juanlu-a/viro_vision/hardware/case-via-clara/README.md

# Carcasa VIA Clara v0.29: dos mitades con cierre a presión

Modelo paramétrico en **OpenSCAD** (`via_clara_v0_29.scad`) para la Raspberry Pi Zero 2 W con el header
soldado, la Waveshare UPS HAT (C) unida a su batería 803040, la Raspberry Pi AI Camera y el auricular
de conducción ósea, montado sobre la patilla de los lentes.

Estado al 2026-11-12, con el PR que integró cada hito a `staging`:

- **v0.20** (#124): impresa y armada completa el 2026-10-30, quedó perfecta. Puesta, la foto salía
  girada 90°, y de ahí salió la línea v0.22 a v0.29 (ver abajo).
- **v0.26** (#129, 2026-11-10): la cámara girada, de modo que la foto sale derecha con el equipo puesto.
- **v0.29, la final** (#131, 2026-11-12): impresa y armada, con la copa del auricular como pieza aparte
  (08) y un enchufe de 6,0 mm que calza perfecto. La v0.27 se imprimió y sólo falló el encastre de la
  copa, que quedaba flojo; la v0.28 achicó el enchufe por error; la v0.24 también se imprimió y se armó.
  El equipo confirmó que no queda nada por probar.
- La v0.8 (`via_clara_v0_8.scad`) se conserva como referencia.

Se imprime en una **FLSUN T1 Max** (las primeras versiones, en una Creality Ender 3 V3): la FLSUN dio bordes
más definidos, mejor terminación y soportes que se retiran con menos marcas.
Para regenerar todo, correr `./export.sh`: arma los STL, las imágenes y las verificaciones, y sale con
error si algo falla.

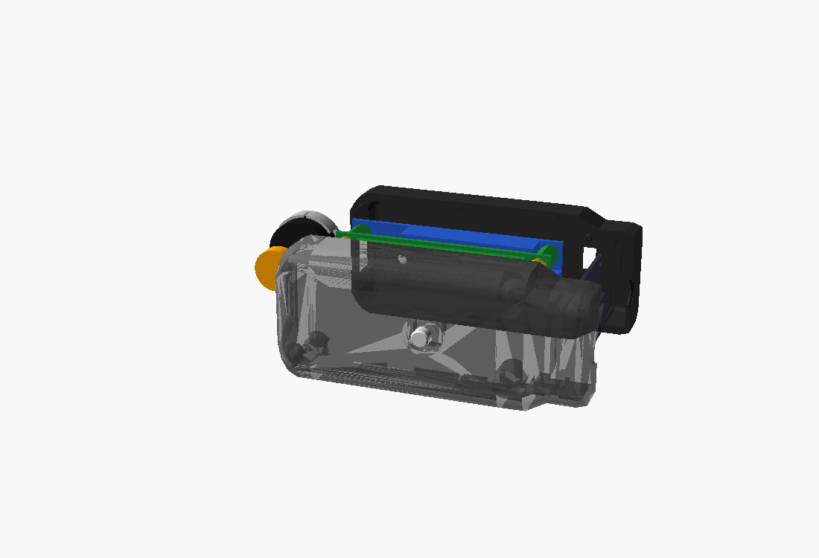
[picture p1: hardware/case-via-clara/img/exploded_with_hardware.png]
Explotada, con las placas y la cámara


Las mitades miden **89,2 mm de largo y 39,8 de alto**, sin contar el brazo del auricular.

## De la v0.20 a la v0.29

Con la v0.20 puesta, la foto salía girada 90°. El detector del ómnibus (YOLO) corre dentro del sensor IMX500,
así que la imagen no se puede girar por software antes de que el detector la vea. Se probaron dos caminos:

- **v0.21**: la carcasa entera girada, con la cara de la HAT arriba. Se descartó.
- **v0.22**: la v0.20 con **sólo la cámara girada**, un cuarto de vuelta en su plano, junto con sus guías.
  El conector del flex mira hacia abajo, hacia la junta, y el lado de 25 mm de la placa queda a lo ancho. El
  flex sale hacia abajo, va hacia atrás por el piso y sube frente a la Pi (`flex_keepout` reserva ese camino).
  El lente queda en la junta, así que el agujero es el lente más 0,4 (8,4). **Es la línea elegida.**

Lo que se fue corrigiendo sobre la v0.22:

| Versión | Cambio | Por qué |
|---|---|---|
| v0.23 | cámara 2 mm más lejos de las placas (10 mm de hueco); la carcasa crece 2 mm | ahí va enrollado el flex |
| v0.23 | tapa del auricular 1,5 mm más alta (`GRILLE_RAISE`), con dedos más largos | la de la v0.22 no hacía click en el brazo |
| v0.24 | ranura de la microSD 1 mm hacia la junta | medida en la impresión |
| v0.24 | guía delantera de la cámara abierta en toda la franja de abajo (7 mm), en las dos mitades | el componente de la cámara rozaba |
| v0.25 | botón centrado en la cara externa | no estaba centrado |
| v0.25 | hueco interior 1,2 mm más alto de cada lado: la carcasa pasa de 37,2 a 39,8 de alto | el mini HDMI y el micro USB de la Pi sobresalen 2 mm del borde, no 0,8; el conjunto entraba a la fuerza. Guías en la pared no entraban: caían sobre las trabas de abajo |
| v0.25 | zócalos hexagonales 2 mm más profundos (5,5) | los hexágonos hacían tope antes de tiempo |
| v0.25 | ganchos de las trabas más anchos (7 y 5 mm) y diente de 0,5 | más robustas |
| v0.25, v0.26 | puentes del elástico 5,5 mm arriba del centro (`ELASTIC_Z`) y zócalo del brazo 5,5 abajo (`ARM_Z`): 11 mm entre la patilla y el brazo; el auricular sigue a la patilla | la patilla del lente pasaba justo por encima del brazo y no se podía usar puesto |
| v0.27 | la copa del auricular, pieza aparte (08), encastrada en la punta del brazo como el brazo en la carcasa | pasar el cable por el brazo era difícil |
| v0.27 | canal del cable de Ø 3,4 (pared del tubo de 1 mm), curva de 3 mm de radio dentro del enchufe y paso de Ø 3,8 abierto en embudo hacia adentro | el cable no pasaba bien: era chico y doblaba a 90° |
| v0.28 | enchufe del brazo para la copa de 5,1 × 5,1, con la copa igual | se supuso que el brazo de la v0.27 no entraba; era al revés |
| v0.29 | enchufe de 6,0 × 6,0 con esquinas de 0,8 (0,15 de luz por lado) y puntas de prueba de 5,8, 6,0 y 6,2 (`test_cup_plug_*`, `PART=print_cup_plug_test` con `CUP_PLUG_TEST`) | el brazo de la v0.27 quedaba flojo en la copa, y el de la v0.28 más todavía |

## Piezas

| STL | Qué es | Orientación | Soportes |
|---|---|---|---|
| `01_left_half` | mitad del lado de la cabeza, con el switch de encendido | cara cabeza abajo | bajo la cara cabeza; bloquearlos dentro de la cavidad |
| `02_right_half` | mitad externa: zócalos, botón, trabas | cara externa abajo | sólo bajo el ahusado trasero y la nariz; **ninguno dentro de los zócalos hexagonales**. Después de imprimir, cortar los puentes de las vigas de las trabas |
| `03_bone_arm` | brazo del auricular, con un enchufe en cada punta | acostado | de árbol |
| `08_transducer_cup` | copa del auricular, con el zócalo para el brazo | piso abajo | no |
| `04_mode_button` | botón: un cilindro que se pega al pulsador | parado | no |
| `07_transducer_cover` | tapa a click del auricular, con una ranura hacia el oído | disco abajo | no |
| `00_assembly_check` | todo armado | no aplica | **no se imprime**: para mirar en el laminador |

Ya no existen la corredera (05), que reemplaza el switch de panel, ni la tapita del botón (06): el
pulsador queda firme en su bolsillo. PLA con *fuzzy skin* en el exterior; boquilla 0,4, capa de 0,12 a 0,16, 3 perímetros. Las curvas salen con 128 segmentos.

**Lo que dejó la impresión de la v0.24** (FLSUN T1 Max, PLA, con fuzzy skin):

- la **02 boca arriba** (cara externa en la cama), siempre: las vigas de las trabas están pensadas para
  imprimirse así, y boca abajo los ganchos quedarían colgando de la junta;
- la **01 boca abajo** (junta en la cama) deja el exterior muy prolijo, pero el borde de la junta pierde
  definición y las trabas no enganchan bien. Para probar: apagar el fuzzy skin en los primeros 3 mm (un
  modificador por altura) y compensar la pata de elefante con 0,2 mm. Si no alcanza, la alternativa es
  imprimirla boca arriba, como dice la tabla.

## Lo que fijaron las impresiones (v0.12 a v0.25)

| Parte | Cómo quedó | De dónde salió |
|---|---|---|
| Cámara | ranura del PCB de 1,62 (nervios de 1,2 a 0,25 de luz), 5 mm del centro del nervio delantero a la cara, 4,2 mm de lugar para el flex, y la esquina del nervio delantero abierta, porque ahí la cámara tiene un componente | narices de prueba de la v0.12 y la v0.13 |
| Trabas delanteras | detrás de las guías de la cámara: encima de ellas costaban y se partieron | impresión de la v0.11 |
| Separadores sobre la Pi | **zócalos hexagonales huecos de 5,0 entre caras, 5,5 de profundidad**, en postes de Ø 8,2 recortados donde tocarían el header y los puertos | `test_hex_sizes` (v0.13; el 5.º tamaño), la v0.15, que con 1,5 no cerraba, y la v0.24, donde 3,5 hacía tope |
| Auricular | redondo, Ø 14 × 5: copa de **Ø 17 × 6** (la de Ø 15 no entró) y tapa sólida a click con una ranura hacia el oído | v0.15 a v0.17 |
| Botón | un cilindro de Ø 5, pegado al pulsador SMD de 4 × 4 × 1 | v0.15 |
| Encendido | **switch deslizante de panel**, cableado al HAT, en lugar de la llave del HAT y la corredera impresa. Ventana de **4,2 × 7,4** en la cara cabeza y dos pernos de **Ø 2,3 a 14,8** entre centros y 2 de alto, para los agujeros de la pestaña; se fija con gotita. La ventana va 2 mm más abajo que la de la corredera, para que la pestaña no toque la esquina redondeada de arriba | `test_panel_switch` (v0.18 y v0.19) |

## Todas las versiones

`versions/` guarda los STL de cada versión tal como se mandaron a imprimir, con su `LEEME`: de la v0.9 a
la v0.29 (desde la v0.21, también el `.scad` de cada una en `modelo/`), incluidas las piezas de prueba (narices, tamaños de hexágono, separaciones del switch). Es el
registro del proceso: no se borra ni se pisa una versión anterior. `./export.sh` vuelve a crear los STL
de la versión vigente en `stl/`, que git ignora.

## Armado

1. **Botón.** Soldar los cables al pulsador de 4 × 4 y pegarle el cilindro (pieza 04). Meterlo desde
   adentro de la mitad derecha, con el cilindro por el agujero.
2. **Cámara y flex.** Conectar el flex a la cámara y al CSI de la Pi **antes** de poner el conjunto.
3. **Electrónica.** Bajar el conjunto HAT + batería + Pi, **con la Pi hacia abajo**, en la mitad derecha:
   los hexágonos de la Pi entran en los zócalos. La cámara entra en su ranura con el conector hacia abajo (hacia la junta) y el lado de 25 mm a lo ancho; el flex baja, va por el piso y sube frente a la Pi hasta su conector.
4. **Switch.** En la mitad izquierda, desde adentro, pasar la perilla del switch por su ventana y
   calzar la pestaña en los dos pernos; una gota de gotita.
5. **Auricular.** Pasar el cable por el puerto de la mitad izquierda, por el brazo (pieza 03) y por la
   copa (pieza 08); encastrar la copa en la punta del brazo y el brazo en su zócalo, poner el
   transductor en la copa y cerrar con la tapa (pieza 07).
6. **Cerrar.** Bajar la mitad izquierda sobre la derecha hasta escuchar las ocho trabas. Para abrir:
   uña o moneda en la ranura trasera.

## Guía con flechas

`img/guide/` tiene cinco vistas con flechas que dicen para qué es cada ranura, agujero y pieza
(`outer`, `head`, `left_inside`, `right_inside`, `exploded`). Las genera `export.sh` a partir de
`via_clara_v0_29_guide.scad`.

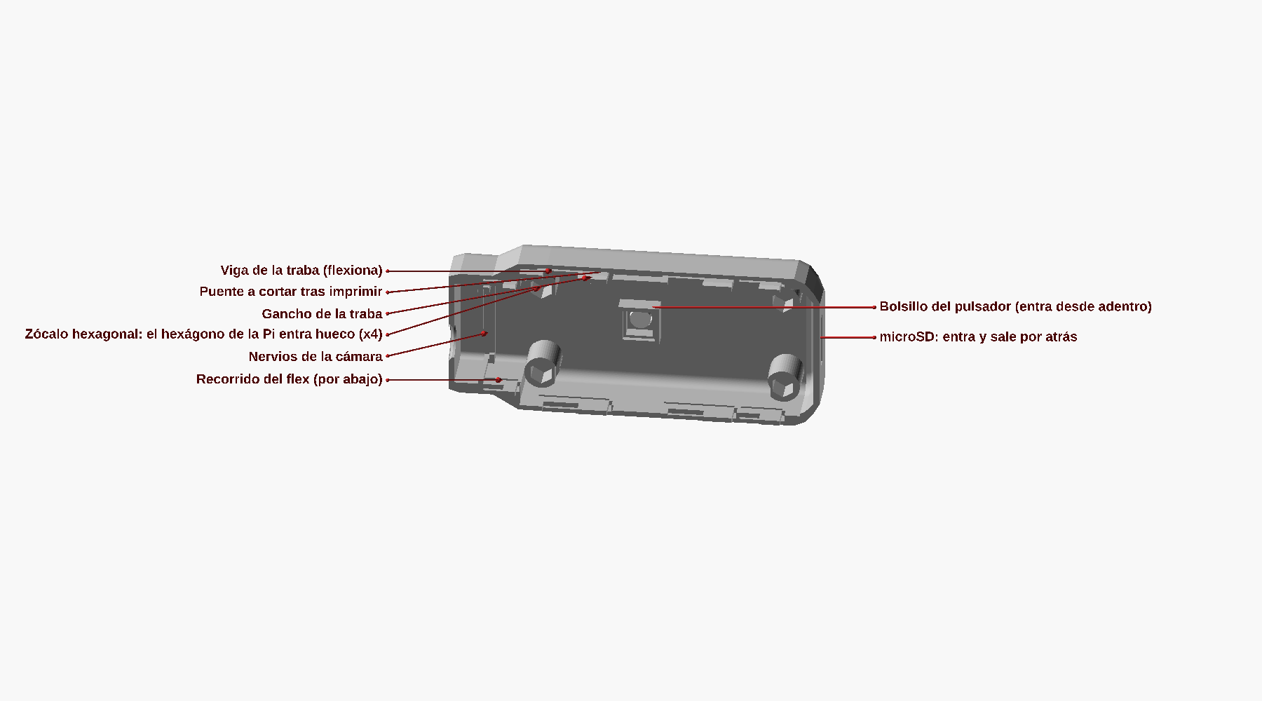
[picture p2: hardware/case-via-clara/img/guide/right_inside.png]
Adentro de la mitad derecha

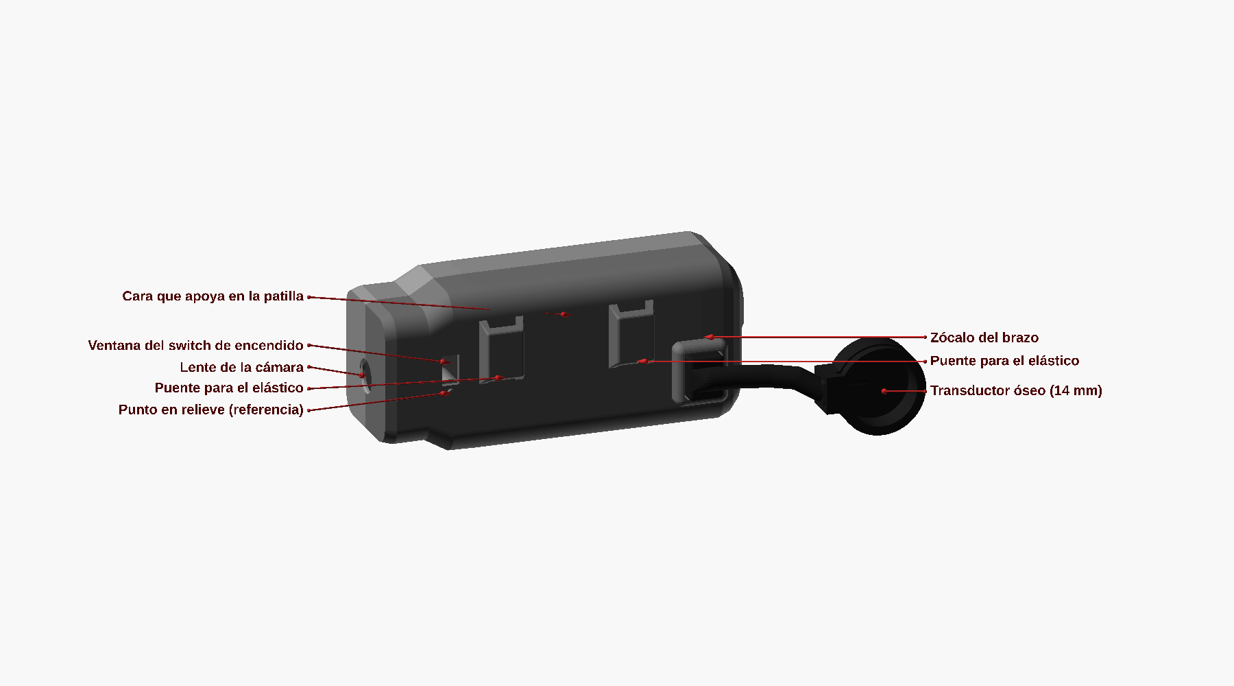
[picture p3: hardware/case-via-clara/img/guide/head.png]
Cara cabeza


## Archivos y verificaciones

```
via_clara_v0_29.scad         el modelo. PART = assembly | left | right | bone | cup | button | grille |
                             print_* | hardware | check_*;  SHOW_HW y EXPLODE para la vista armada
via_clara_v0_29_guide.scad   la guía con flechas (img/guide/); no se imprime
via_clara_v0_8.scad          la versión de partida, sin tocar, como referencia
export.sh                    regenera stl/ e img/ y corre las verificaciones
versions/                    los STL de cada versión, v0.9 a v0.29
```

`export.sh` comprueba que cada pieza imprimible sea **un solo sólido** que apoya en la cama, y corre
**18 verificaciones** de interferencia que tienen que dar vacío o un contacto de volumen cero: las
mitades entre sí y contra las maquetas del hardware, los zócalos contra los hexágonos, el botón, los
pernos del switch, el recorrido del flex, el brazo y su tapa, y los caminos de armado (botón, conjunto,
cámara). Valen **contra las maquetas**, y las maquetas valen tanto como las medidas: lo que no tienen
(el cuerpo del switch de panel, por ejemplo) no lo ven.

## De dónde salen las medidas

| Componente | Fuente |
|---|---|
| Raspberry Pi Zero 2 W | plano mecánico oficial: 65 × 30, agujeros 58 × 23 |
| AI Camera | product brief (sept. 2024), pág. 4, corregido con las impresiones |
| UPS HAT (C) | wiki de Waveshare (fotos escaladas) y la impresión de la v0.9 |
| Hexágonos, disipador, pulsador, auricular, switch | medidos con calibre y con piezas de prueba |

El conjunto, de la cara cabeza a la externa: cabezas de los tornillos Phillips, UPS HAT, batería
(del lado de los pogo pins), Pi, y encima de la Pi el header y los hexágonos. Adelante quedan el CSI
y la cámara; atrás, la microSD (sale por una ranura del extremo trasero) y el micro USB de carga.
