juanlu-a/viro_vision/hardware/raspi/requirements-mac.txt

# Only for the device emulator on macOS (python -m virovision.emulator). It does not go to the device.
bless==0.3.0
