juanlu-a/viro_vision/docs/mediciones/README.md

# Mediciones

Registro de las campañas de medición del proyecto: **los datos crudos y el método**, un archivo por
campaña, con fecha en el nombre.

Existe separado de [`../pruebas-y-decisiones.md`](../pruebas-y-decisiones.md) por la misma razón por
la que el diagrama canónico vive en un solo lugar: ahí va **el análisis y la decisión** —que es lo
que entra al documento final de la tesis— y acá los números completos que la respaldan, para que la
conclusión se pueda auditar y la medición se pueda repetir sin reconstruirla de memoria.

Regla: una campaña no se edita después de corrida. Si se vuelve a medir, es un archivo nuevo. Los
números viejos son el registro de qué se sabía cuándo, y borrarlos hace que las decisiones tomadas
con ellos parezcan arbitrarias.

| Campaña | Qué midió |
|---|---|
| [2026-09-02 — modelos de supermercado](2026-09-02-modelos-supermercado.md) | Latencia, acierto, cuota, costo y efecto del tamaño de imagen de los tres proveedores con clave. |
| [2026-09-15 — el modo ómnibus en la placa](2026-09-15-omnibus-en-placa.md) | Latencia del camino de ómnibus entero corriendo en el dispositivo, disparado por el botón. |
