juanlu-a/viro_vision/hardware/case-via-clara/img/closed_head_side.png

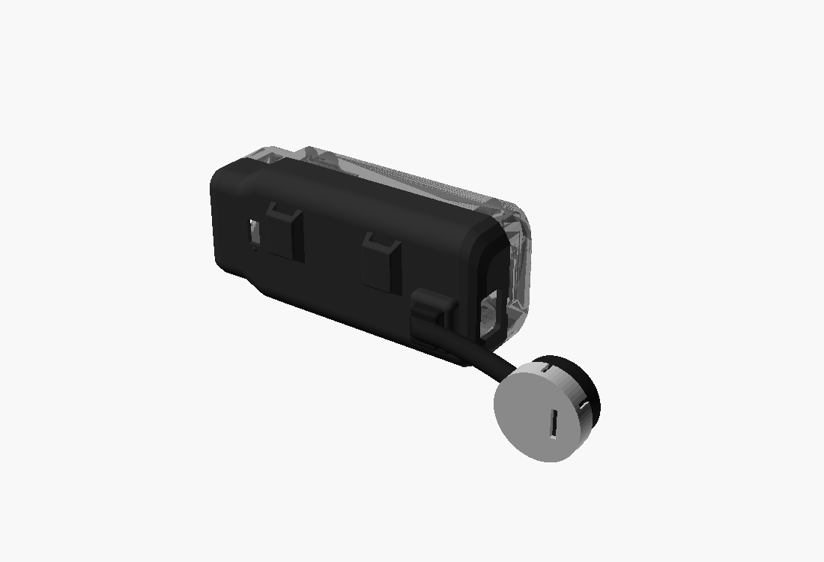
hardware/case-via-clara/img/closed_head_side.png
