juanlu-a/viro_vision/hardware/case-via-clara/img/closed_outer.png

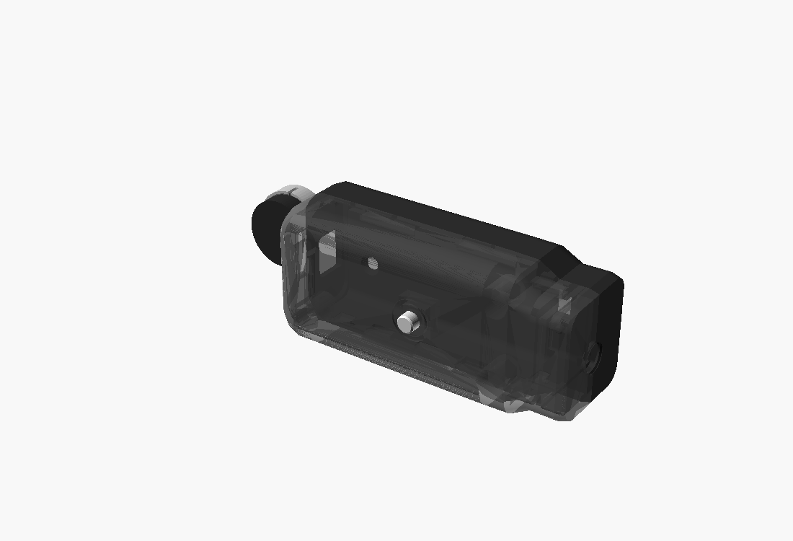
hardware/case-via-clara/img/closed_outer.png
