juanlu-a/viro_vision/hardware/case-via-clara/img/head_side_switch.png

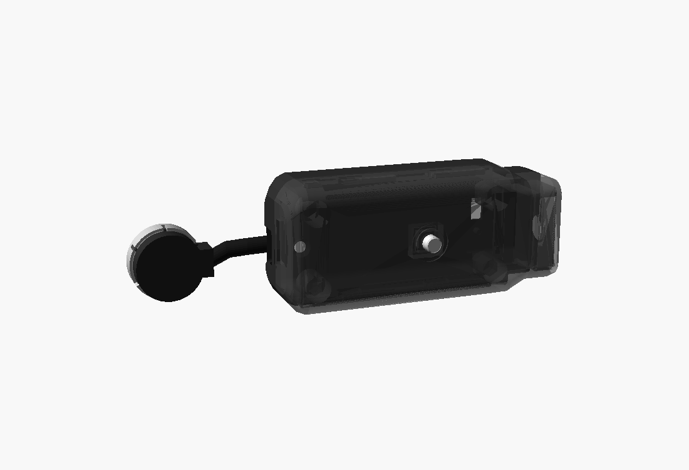
hardware/case-via-clara/img/head_side_switch.png
