juanlu-a/viro_vision/hardware/case-via-clara/img/left_half_inside.png

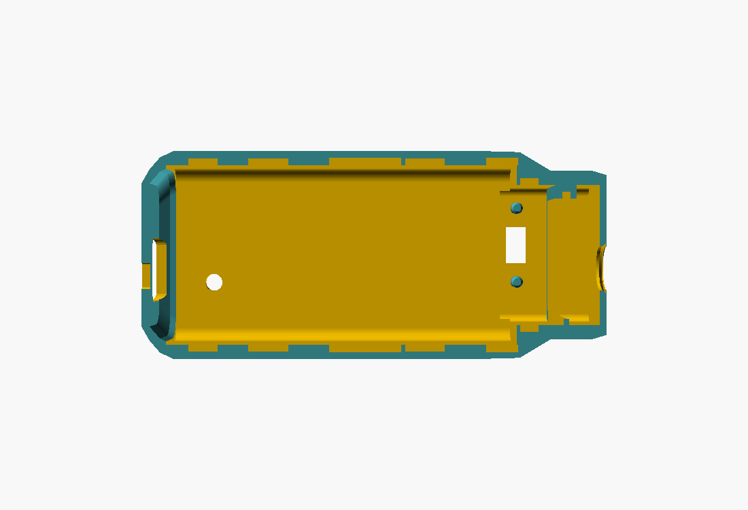
hardware/case-via-clara/img/left_half_inside.png
