juanlu-a/viro_vision/hardware/case-via-clara/img/rear_openings.png

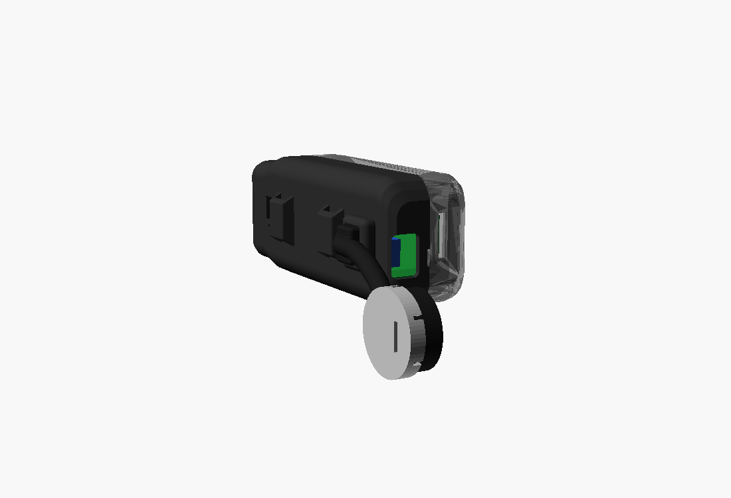
hardware/case-via-clara/img/rear_openings.png
