juanlu-a/viro_vision/hardware/case-via-clara/versions/v0_29/pruebas/test_cup_plug_6_2_v0_29.stl

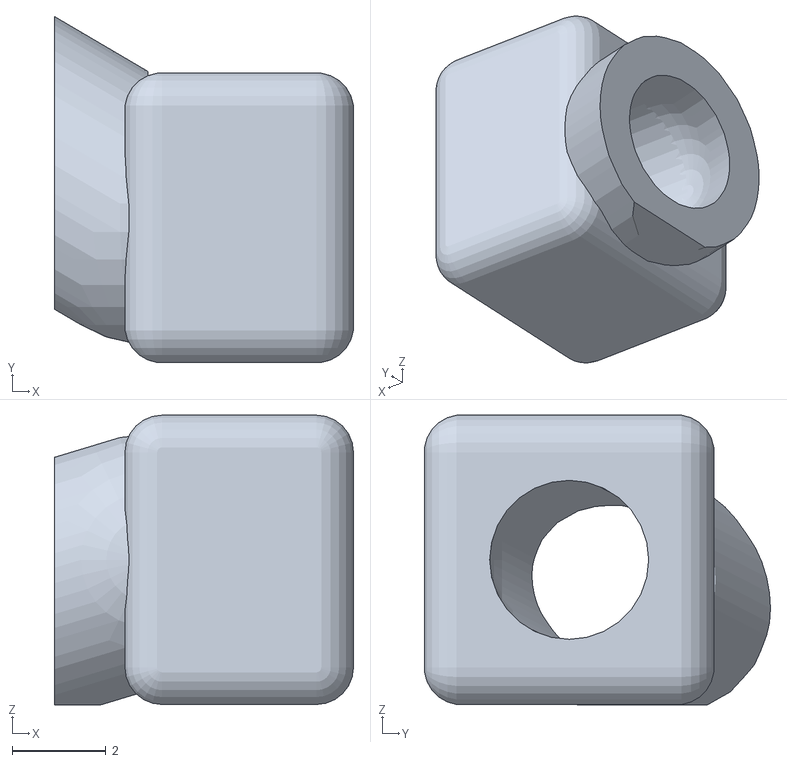
[picture p10: CAD file, 2026-11-12]
hardware/case-via-clara/versions/v0_29/pruebas/test_cup_plug_6_2_v0_29.stl
6.39 x 7.40 x 6.19
