juanlu-a/viro_vision/hardware/case-via-clara/versions/v0_29/pruebas/test_cup_plug_6_0_v0_29.stl

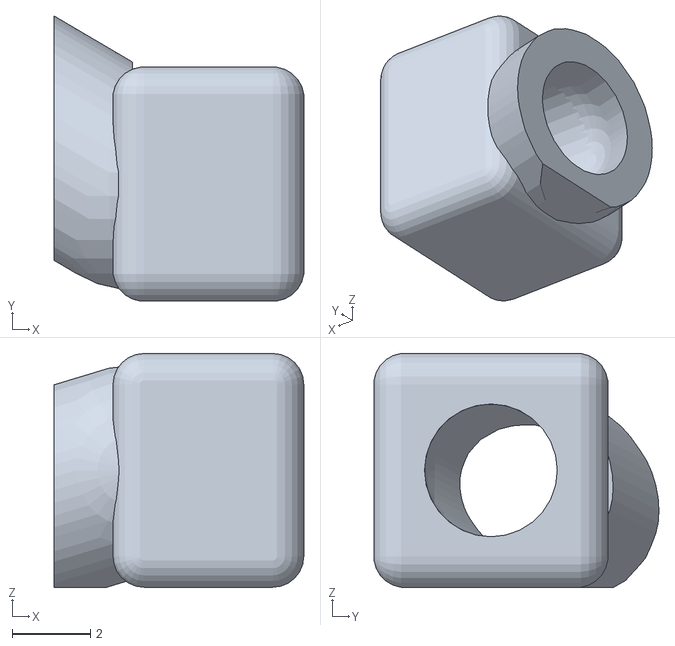
[picture p11: CAD file, 2026-11-12]
hardware/case-via-clara/versions/v0_29/pruebas/test_cup_plug_6_0_v0_29.stl
6.39 x 7.30 x 5.99
