juanlu-a/viro_vision/hardware/case-via-clara/versions/v0_11/con_tapa/00_assembly_check_v0_11_tapa.stl

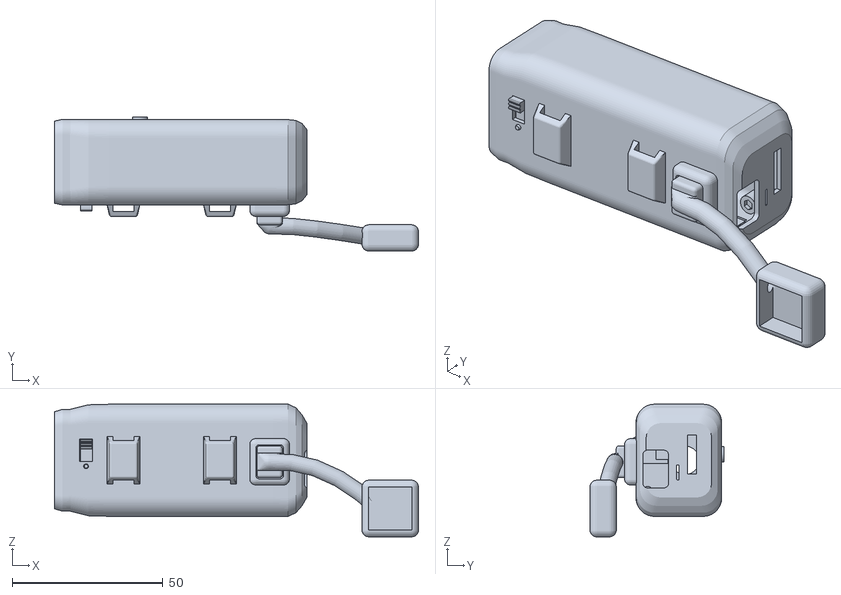
[picture p12: CAD file, 2026-10-31, an earlier design]
hardware/case-via-clara/versions/v0_11/con_tapa/00_assembly_check_v0_11_tapa.stl
120.8 x 44.5 x 44.0
