juanlu-a/viro_vision/hardware/case-via-clara/versions/v0_15/00_assembly_check_v0_15.stl

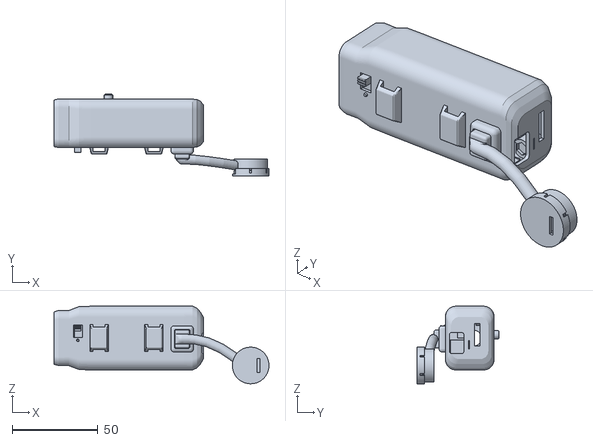
[picture p13: CAD file, 2026-10-31, an earlier design]
hardware/case-via-clara/versions/v0_15/00_assembly_check_v0_15.stl
125.5 x 47.8 x 45.3
