juanlu-a/viro_vision/hardware/case-via-clara/versions/v0_10/00_assembly_check_v0_10.stl

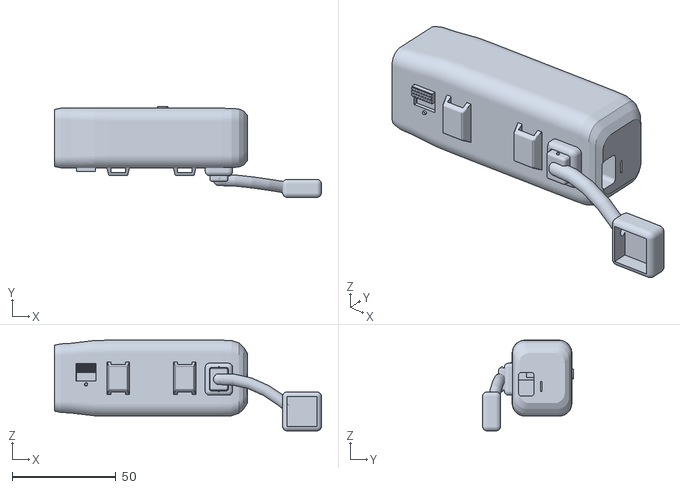
[picture p14: CAD file, 2026-10-31, an earlier design]
hardware/case-via-clara/versions/v0_10/00_assembly_check_v0_10.stl
128.5 x 43.8 x 43.7
