juanlu-a/viro_vision/hardware/case-via-clara/versions/v0_14/00_assembly_check_v0_14.stl

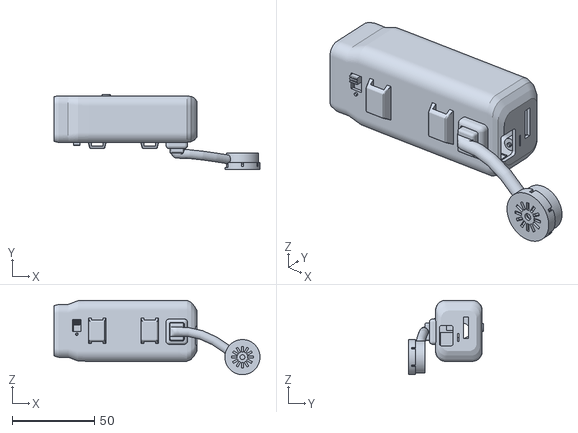
[picture p15: CAD file, 2026-10-31, an earlier design]
hardware/case-via-clara/versions/v0_14/00_assembly_check_v0_14.stl
125.5 x 45.7 x 45.3
