juanlu-a/viro_vision/hardware/case-via-clara/versions/v0_24/00_assembly_check_v0_24.stl

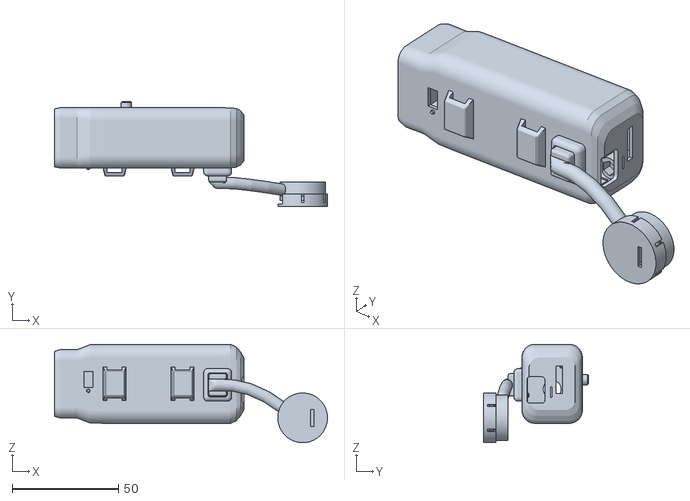
[picture p16: CAD file, 2026-11-10, an earlier design]
hardware/case-via-clara/versions/v0_24/00_assembly_check_v0_24.stl
128.5 x 49.2 x 46.3
