juanlu-a/viro_vision/hardware/case-via-clara/versions/v0_10/03_bone_arm_v0_10.stl

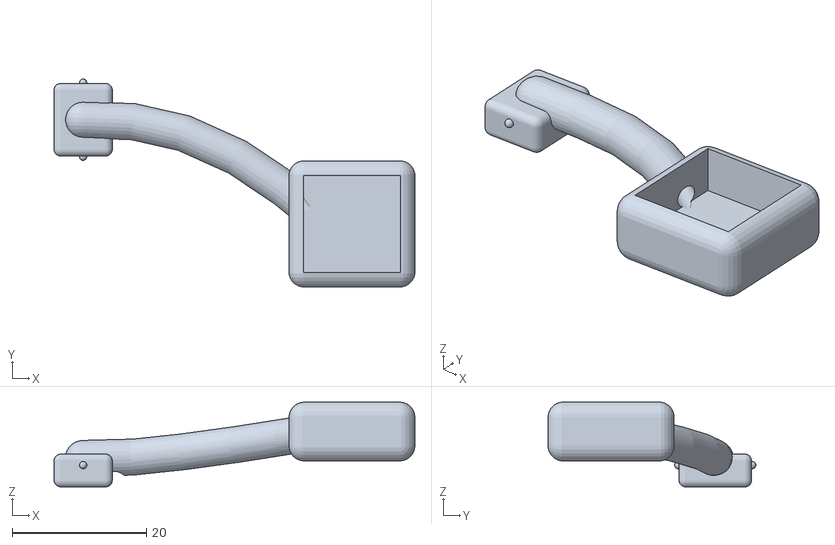
[picture p17: CAD file, 2026-10-31, an earlier design]
hardware/case-via-clara/versions/v0_10/03_bone_arm_v0_10.stl
53.7 x 30.9 x 12.6
