juanlu-a/viro_vision/hardware/case-via-clara/versions/v0_11/01_left_half_v0_11.stl

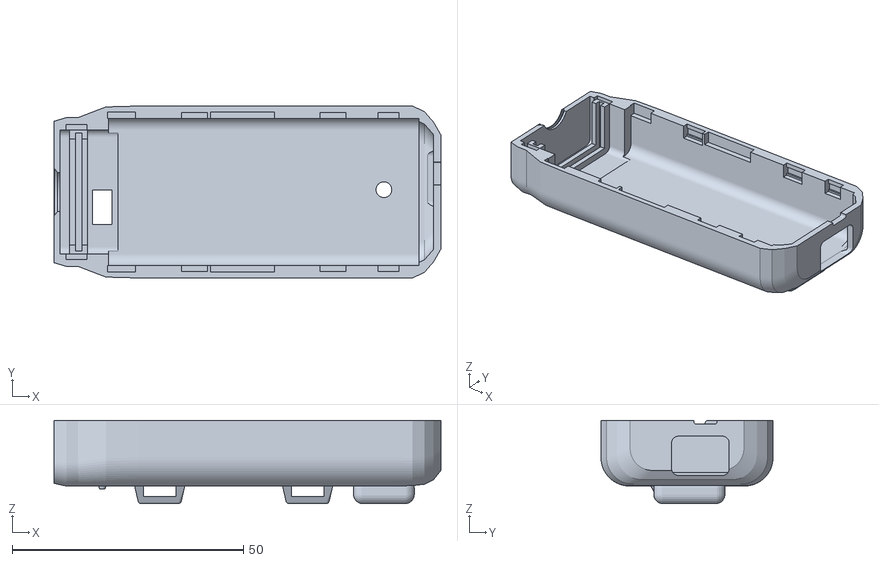
[picture p18: CAD file, 2026-10-31, an earlier design]
hardware/case-via-clara/versions/v0_11/01_left_half_v0_11.stl
83.7 x 37.2 x 18.0
