juanlu-a/viro_vision/hardware/case-via-clara/versions/v0_12/ranura_+0.2/test_nose_right_slot_plus02_v0_12.stl

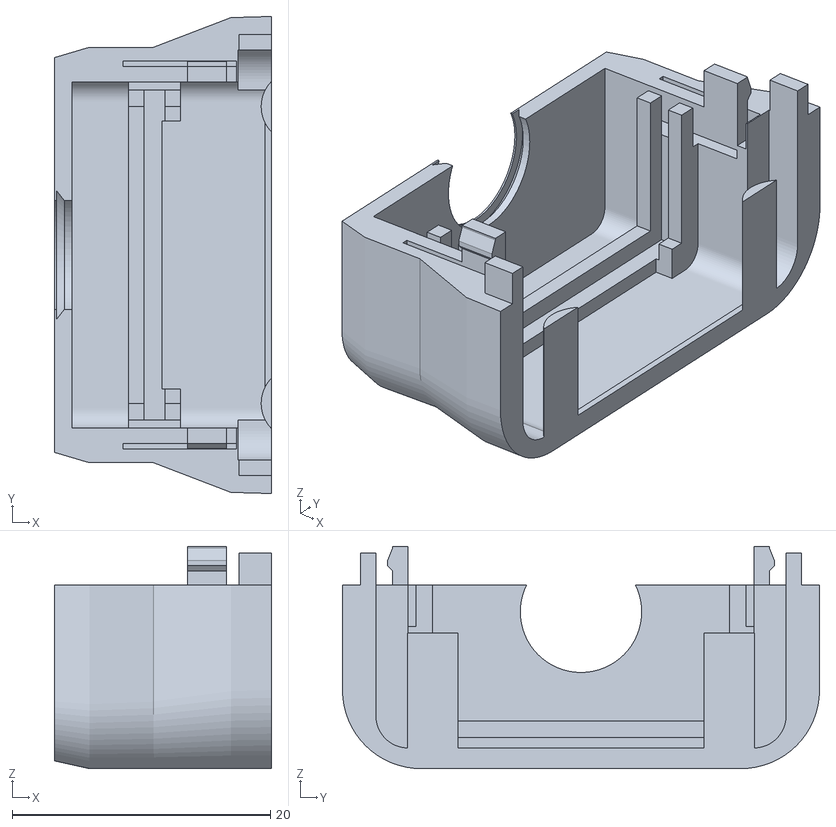
[picture p19: CAD file, 2026-10-31, an earlier design]
hardware/case-via-clara/versions/v0_12/ranura_+0.2/test_nose_right_slot_plus02_v0_12.stl
16.8 x 37.0 x 17.2
