juanlu-a/viro_vision/hardware/case-via-clara/versions/v0_12/test_pads_v0_12.stl

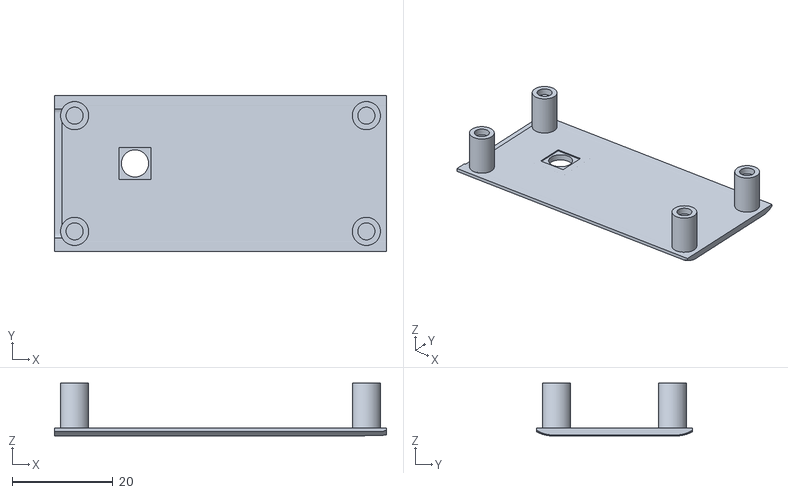
[picture p20: CAD file, 2026-10-31, an earlier design]
hardware/case-via-clara/versions/v0_12/test_pads_v0_12.stl
66.0 x 31.0 x 10.5
