juanlu-a/viro_vision/hardware/case-via-clara/versions/v0_13/test_hex_sizes_v0_13.stl

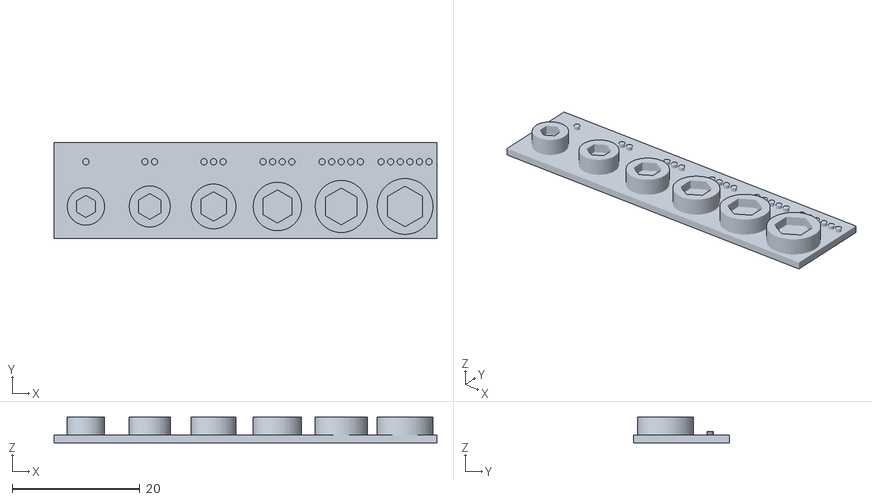
[picture p21: CAD file, 2026-10-31, an earlier design]
hardware/case-via-clara/versions/v0_13/test_hex_sizes_v0_13.stl
60.0 x 15.0 x 4.00
