juanlu-a/viro_vision/hardware/case-via-clara/versions/v0_14/02_right_half_v0_14.stl

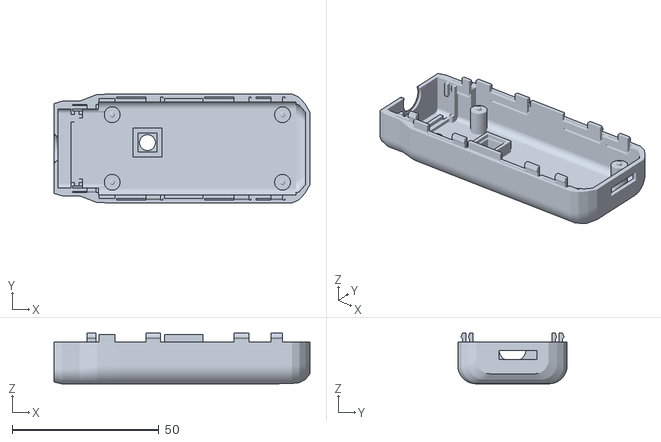
[picture p22: CAD file, 2026-10-31, an earlier design]
hardware/case-via-clara/versions/v0_14/02_right_half_v0_14.stl
87.2 x 37.2 x 17.2
