juanlu-a/viro_vision/hardware/case-via-clara/versions/v0_17/03_bone_arm_v0_17.stl

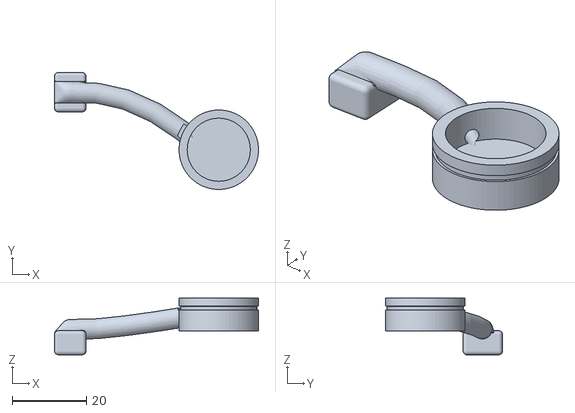
[picture p23: CAD file, 2026-10-31, an earlier design]
hardware/case-via-clara/versions/v0_17/03_bone_arm_v0_17.stl
54.9 x 31.5 x 15.2
