juanlu-a/viro_vision/hardware/case-via-clara/versions/v0_19/pernos_2.9/test_panel_switch_v0_19_d2.9.stl

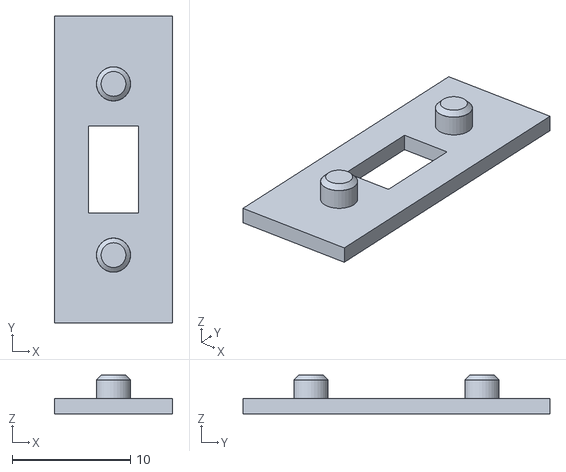
[picture p24: CAD file, 2026-10-31, an earlier design]
hardware/case-via-clara/versions/v0_19/pernos_2.9/test_panel_switch_v0_19_d2.9.stl
10.0 x 26.0 x 3.28
