juanlu-a/viro_vision/(list of files, cad)

Other CAD files:
hardware/case-via-clara/versions/v0_16/00_assembly_check_v0_16.stl
hardware/case-via-clara/versions/v0_18/03_bone_arm_v0_18.stl
hardware/case-via-clara/versions/v0_19/test_panel_switch_v0_19.stl
hardware/case-via-clara/via_clara_v0_8.scad
hardware/case-via-clara/versions/v0_9/via_clara_v0_9_guide.scad
hardware/case-via-clara/versions/v0_21/modelo/via_clara_v0_21.scad
hardware/case-via-clara/versions/v0_10/04_mode_button_v0_10.stl
hardware/case-via-clara/versions/v0_10/05_power_slider_v0_10.stl
hardware/case-via-clara/versions/v0_11/con_tapa/06_button_lid_v0_11.stl
hardware/case-via-clara/versions/v0_11/con_tapa/07_camera_cap_v0_11_tapa.stl
hardware/case-via-clara/versions/v0_13/test_nose_left_v0_13.stl
hardware/case-via-clara/versions/v0_15/07_transducer_cover_v0_15.stl
hardware/case-via-clara/versions/v0_16/02_right_half_v0_16.stl
hardware/case-via-clara/versions/v0_18/test_panel_switch_v0_18.stl
hardware/case-via-clara/versions/v0_20/02_right_half_v0_20.stl
hardware/case-via-clara/versions/v0_21/02_bottom_half_v0_21.stl
hardware/case-via-clara/versions/v0_21/modelo/via_clara_v0_21_guide.scad
hardware/case-via-clara/versions/v0_21/pruebas/test_nose_left_v0_21.stl
hardware/case-via-clara/versions/v0_21/pruebas/test_nose_right_v0_21.stl
hardware/case-via-clara/versions/v0_21/pruebas/test_pads_v0_21.stl
hardware/case-via-clara/versions/v0_22/modelo/via_clara_v0_22_guide.scad
hardware/case-via-clara/versions/v0_23/01_left_half_v0_23.stl
hardware/case-via-clara/versions/v0_23/02_right_half_v0_23.stl
hardware/case-via-clara/versions/v0_23/modelo/via_clara_v0_23.scad
hardware/case-via-clara/versions/v0_24/02_right_half_v0_24.stl
hardware/case-via-clara/versions/v0_24/03_bone_arm_v0_24.stl
hardware/case-via-clara/versions/v0_24/modelo/via_clara_v0_24_guide.scad
hardware/case-via-clara/versions/v0_24/pruebas/test_nose_right_v0_24.stl
hardware/case-via-clara/versions/v0_25/01_left_half_v0_25.stl
hardware/case-via-clara/versions/v0_25/modelo/via_clara_v0_25.scad
hardware/case-via-clara/versions/v0_26/pruebas/test_nose_right_v0_26.stl
hardware/case-via-clara/versions/v0_26/pruebas/test_pads_v0_26.stl
hardware/case-via-clara/versions/v0_27/03_bone_arm_v0_27.stl
hardware/case-via-clara/versions/v0_27/08_transducer_cup_v0_27.stl
hardware/case-via-clara/versions/v0_28/08_transducer_cup_v0_28.stl
hardware/case-via-clara/versions/v0_28/modelo/via_clara_v0_28.scad
hardware/case-via-clara/versions/v0_9/02_right_half_v0_9.stl
hardware/case-via-clara/versions/v0_9/04_mode_button_v0_9.stl
