juanlu-a/viro_vision/docs/brand/virovision-manual-de-marca.pdf

M A N U A L D E M A R C A · V 1 . 0 · 2 0 2 6

# ViroVision

Asistente de hardware para personas

ciegas. Una cámara con IA que reconoce

líneas de colectivo y productos de

supermercado, y lo comunica por voz.

Solo símbolo Técnico y sobrio

Verde + azul

## El símbolo

01

Dos arcos que se encuentran en un vértice inferior. Leídos

juntos forman un ojo abstracto; leídos por su punto de

unión, una V geométrica. El punto central es la pupila y

también el objeto detectado: el foco de la cámara.

El arco azul representa el dispositivo; el verde, la lectura

confirmada. La marca funciona sin texto: es un símbolo

único, sin logotipo acompañante.

## Construcción y resguardo

02

Lienzo 200×200 ·
radio de arco 96 ·
trazo 18 · pupila
r17 en (100, 92)

Área de resguardo =
1× el diámetro de la
pupila (34 u) en los
cuatro lados. Tamaño
mínimo: 24 px en
pantalla, 10 mm
impreso.

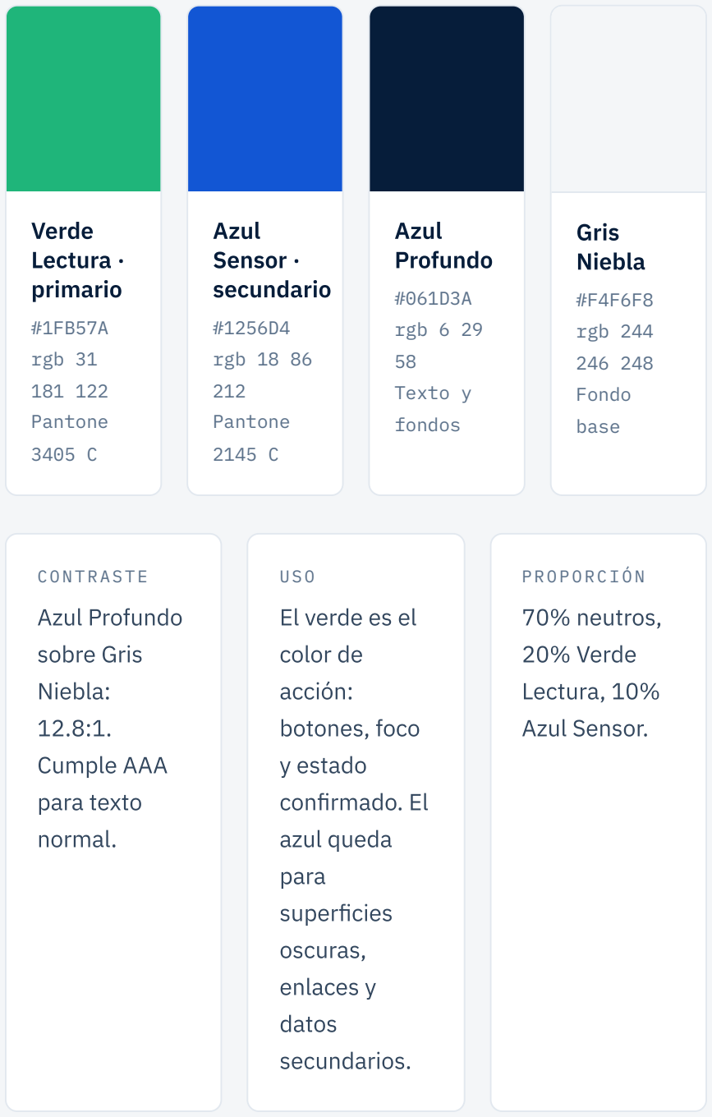
[picture p25: figure]
Verde; Lectura ·; primario; #1FB57A rgb 31 181 122 Pantone 3405 C; Azul; Sensor ·; secundario; #1256D4 rgb 18 86 212 Pantone 2145 C; Profundo; #061D3A rgb 6 29 58 Texto y fondos; Gris; Niebla; #F4F6F8 rgb 244 246 248 Fondo base; CONTRASTE; Azul Profundo; sobre Gris; Niebla:; Cumple AAA; para texto; normal.; USO; El verde es el; color de; acción:; botones, foco; y estado; confirmado. El; azul queda; para; superficies; oscuras,; enlaces y; datos; secundarios.; PROPORCIÓN; 70% neutros,; 20% Verde; Lectura, 10%; Azul Sensor.

## Color

03

## Tipografía

04

TÍTULOS · SPACE GROTESK BOLD

# Detecta y avisa

Aa Bb Cc 0123456789 · 32–72 px · tracking −2%

TEXTO · IBM PLEX SANS REGULAR / SEMIBOLD

La app anuncia el número de línea al

acercarse el colectivo y lee la etiqueta del

producto que la cámara tiene enfrente.

Tamaño mínimo en pantalla: 17 px.

DATOS · IBM PLEX MONO

## LÍNEA 60 · 98% · 12 m

## Versiones

05

Principal

Fondo
oscuro | Mono
| positivo

Mono
negativo

## Ícono de app

06

180 px | 120 px | 76 px

### 48 px

El símbolo ocupa el 64% del lienzo del ícono. Por debajo de 76 px el trazo engrosa a 20–24 u y la pupila crece para no cerrarse. Radio de esquina: 22% del lado (iOS aplica su propia máscara).

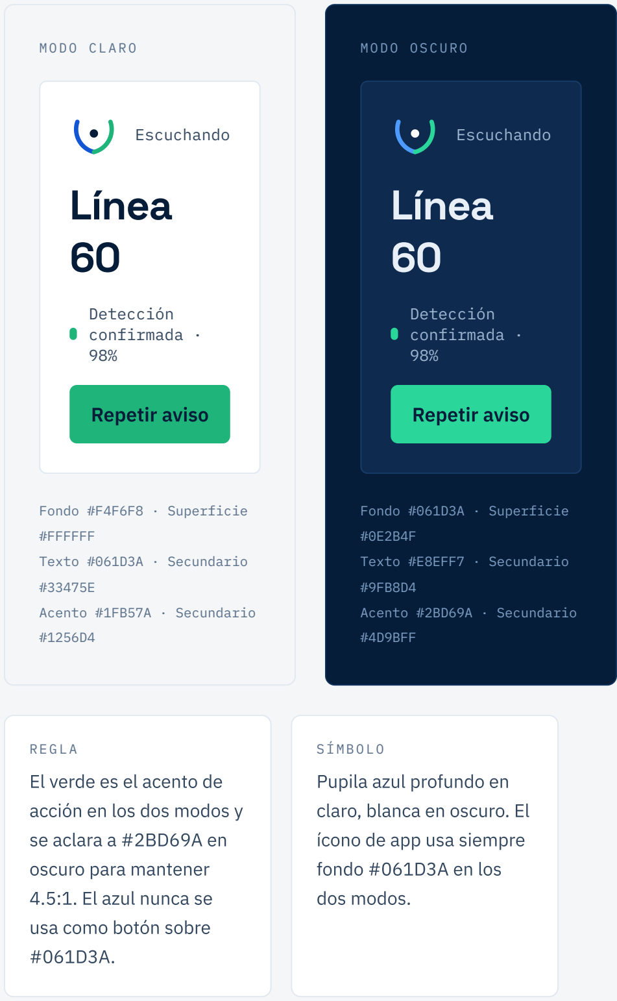
[picture p26: figure]
MODO CLARO; Escuchando; Línea 60; Detección confirmada · 98%; Repetir aviso; Fondo #F4F6F8 · Superficie; #FFFFFF; Texto #061D3A · Secundario; Acento #1FB57A · Secundario #1256D4; MODO OSCURO; Fondo #061D3A · Superficie; Texto #E8EFF7 · Secundario; Acento #2BD69A · Secundario #4D9BFF; REGLA; El verde es el acento de; acción en los dos modos y; se aclara a #2BD69A en; oscuro para mantener; 4.5:1. El azul nunca se; usa como botón sobre; SÍMBOLO; Pupila azul profundo en; claro, blanca en oscuro. El; ícono de app usa siempre; fondo #061D3A en los; dos modos.

## Modo claro y oscuro

07

## Usos incorrectos

08

No
recolorear
fuera de
la paleta

No
deformar
ni estirar

Sin
sombras
ni
efectos

No sobre
fondos
de bajo
contraste

## Exportar

09

Código fuente del símbolo, listo para pegar en tu agente, en

el repo o en Figma.

<svg viewBox="0 0 200 200" xmlns="http://www.w3.org/200 <g fill="none" stroke-linecap="round" stroke-width="1 <path d="M100 168 A 96 96 0 0 1 32 44" stroke="#125 <path d="M100 168 A 96 96 0 0 0 168 44" stroke="#1F </g>
<circle cx="100" cy="92" r="17" fill="#061D3A"/> </svg>

virovisionlogo.svg
Símbolo a
color (https://dc9717d5-faa9-4cc0-b73d-4a99092563c5.claudeusercontent.com/v1/design/projects/dc9717d5-faa9-4cc0-b73d-4a99092563c5/serve/virovision-logo.svg)

virovisionlogomono.svg
Monocromo,
currentColor (https://dc9717d5-faa9-4cc0-b73d-4a99092563c5.claudeusercontent.com/v1/design/projects/dc9717d5-faa9-4cc0-b73d-4a99092563c5/serve/virovision-logo-mono.svg)

virovisionapp-icon.svg
Ícono 1024,
fondo
incluido (https://dc9717d5-faa9-4cc0-b73d-4a99092563c5.claudeusercontent.com/v1/design/projects/dc9717d5-faa9-4cc0-b73d-4a99092563c5/serve/virovision-app-icon.svg)

virovision-marca.md · resumen de marca en texto para tu agente (https://dc9717d5-faa9-4cc0-b73d-4a99092563c5.claudeusercontent.com/v1/design/projects/dc9717d5-faa9-4cc0-b73d-4a99092563c5/serve/virovision-marca.md)
