juanlu-a/viro_vision/hardware/case-via-clara/img/guide/exploded.png

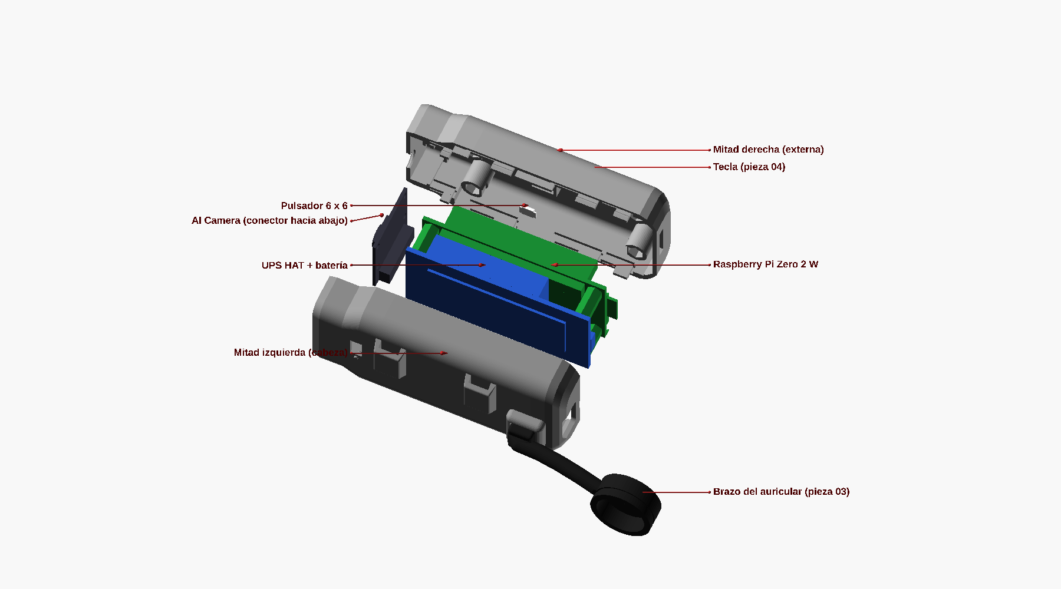
hardware/case-via-clara/img/guide/exploded.png
