juanlu-a/viro_vision/hardware/case-via-clara/img/guide/left_inside.png

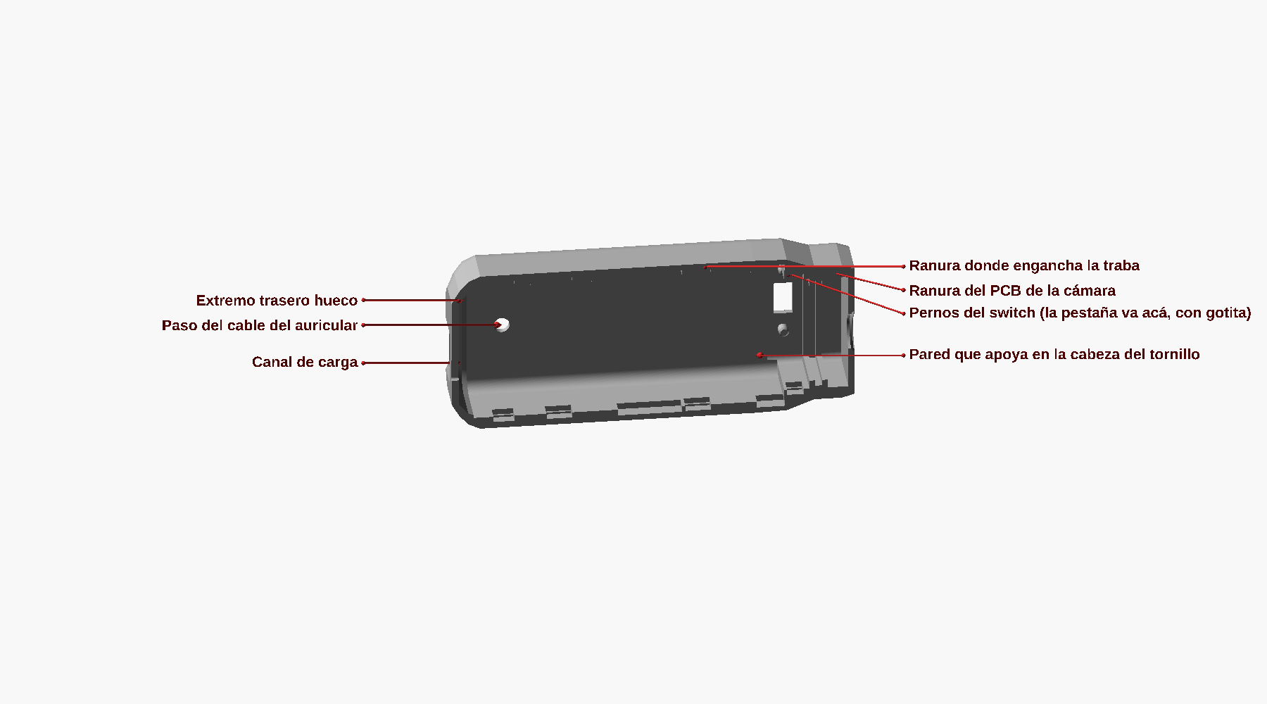
hardware/case-via-clara/img/guide/left_inside.png
