juanlu-a/viro_vision/hardware/case-via-clara/img/guide/outer.png

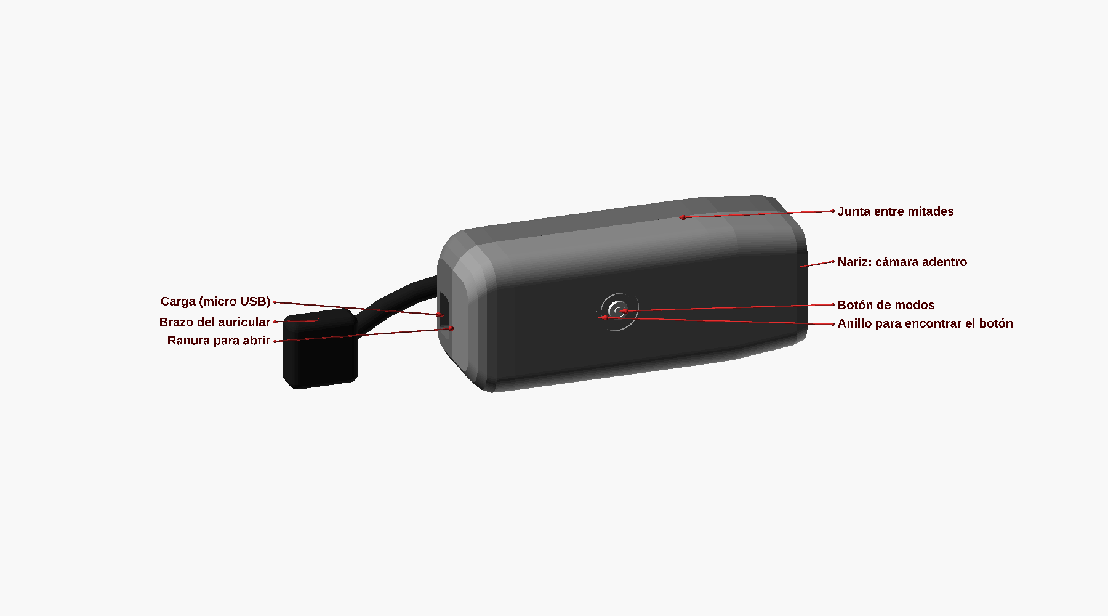
hardware/case-via-clara/img/guide/outer.png
