juanlu-a/viro_vision/documents/logicas-casos-de-uso.pdf

## CASO BONDI: Partial model on Raspi

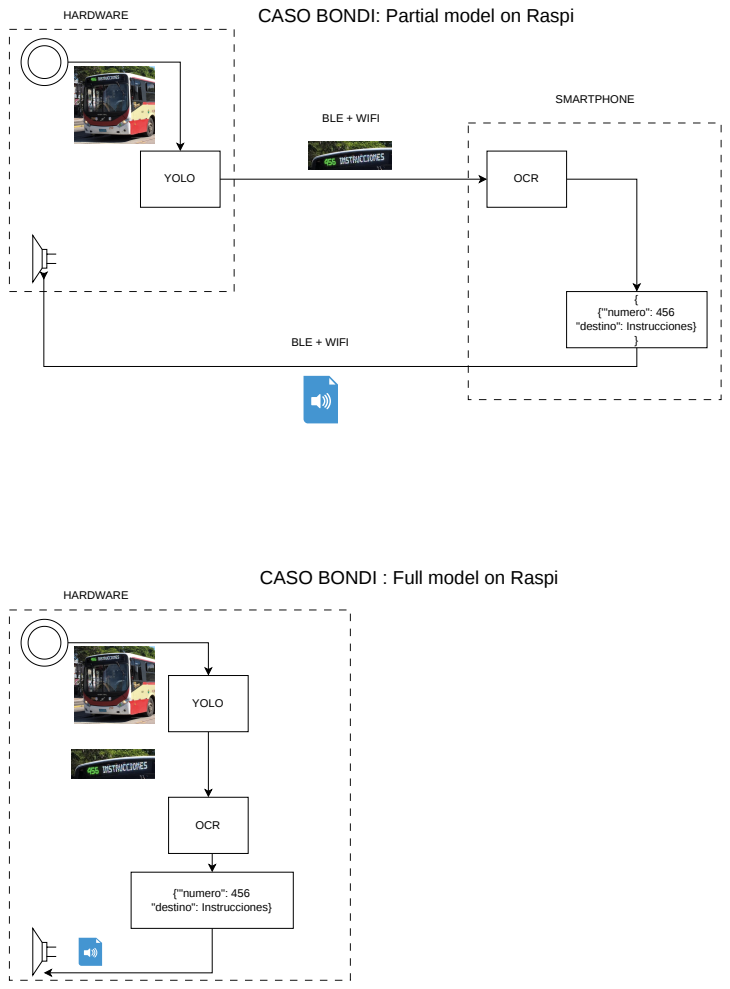
[picture p30: page 1]
YOLO; OCR; { {'"numero": 456 "destino": Instrucciones} }; HARDWARE; SMARTPHONE; BLE + WIFI; {'"numero": 456 "destino": Instrucciones}

CASO BONDI : Full model on Raspi

## CASO SUPER: Model in cloud

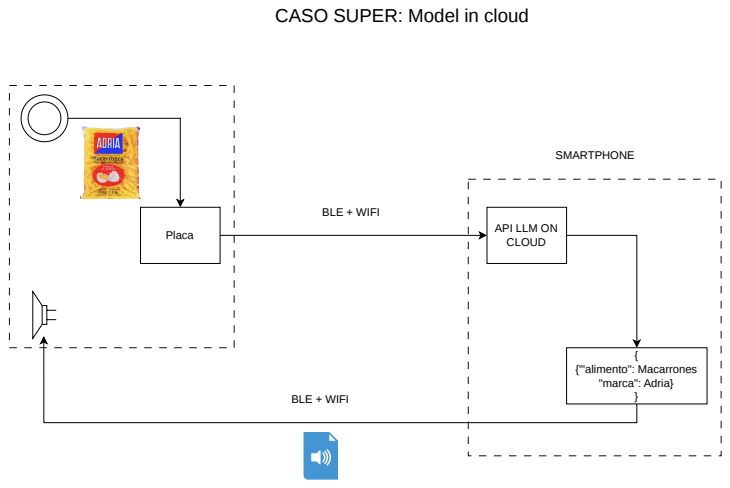
[picture p31: page 2]
Placa; API LLM ON; CLOUD; { {'"alimento": Macarrones "marca": Adria} }; SMARTPHONE; BLE + WIFI
