juanlu-a/viro_vision/hardware/raspi/virovision/audio.py

"""Playing the audio the phone sends back (supermarket mode, ADR 0003).

The whole flow the user feels: **two clicks** → the app pulls the photo over WiFi → the cloud model
reads it → the app synthesizes the sentence and POSTs it to `/audio` → **this plays it on the
device's speaker**. That last step is what was missing: `http_server.py` already accepted the file,
wrote it to `/tmp/virovision-audio/` and called a `play` callable that `__main__` never passed, so
every reading arrived at the device and died there, silently, with a 202 that claimed success.

Three decisions worth keeping:

**It does not wait for the audio to finish.** `Popen`, not `run`. The HTTP handler that calls this
runs on the server's thread and has to answer right away — the app `await`s that response, and
holding it open for the length of the sentence would make the phone think the device is slow when it
is actually talking.

**A new reading interrupts the one playing.** In front of the shelf the user asks for the next
product before the previous sentence has finished, and two voices at once is worse than either one:
for someone who cannot see the screen, overlapping audio is not information. The app's own `speak()`
already interrupts for the same reason.

**It degrades to a log, never to an exception.** No decoder installed, no sound card, no speaker
wired yet: the daemon has to keep answering BLE. A device that stops working because the earphone
is not soldered would be much worse than a silent one.
"""

from __future__ import annotations

import logging
import queue
import shutil
import subprocess
import threading
from pathlib import Path
from typing import Optional

log = logging.getLogger(__name__)

# Set at startup so the level is the same after every boot. Before this it was whatever `amixer` had
# been left at by hand, which on 2026-09-11 meant the first real reading came out too quiet to use.
#
# 90 and not 100: PWM audio clips at the top, and clipping is *worse* than quieter — a distorted
# sentence is harder to understand than a soft one, and understanding it is the entire point.
DEFAULT_VOLUME_PERCENT = 90

# Tried in order; the first control that exists wins. `Softvol` is the one an I2S DAC will need (the
# MAX98357A has no volume control of its own), `PCM` is what the Pi's own output is called.
MIXER_CONTROLS = ("Softvol", "PCM", "Master", "Speaker", "Digital")


def set_output_volume(percent: int = DEFAULT_VOLUME_PERCENT) -> bool:
    """Sets the output level, best-effort. Returns whether it was applied.

    `amixer -M` and not plain `amixer`: without `-M` the percentage is a position on the control's dB
    scale, where 40 % is nearly inaudible; `-M` maps it to *perceived* volume, which is what a person
    means by "louder".

    Failing is not an error worth stopping for: a board with no sound card yet still has to run.
    """
    percent = max(0, min(100, percent))
    control = _find_control()
    if control is None:
        log.warning("audio: no ALSA control to set the volume on")
        return False
    try:
        subprocess.run(
            ["amixer", "-M", "-q", "set", control, f"{percent}%"],
            check=True, capture_output=True, timeout=5,
        )
    except (OSError, subprocess.SubprocessError) as exc:
        log.warning("audio: could not set %s to %d%%: %s", control, percent, exc)
        return False
    log.info("audio: %s at %d%%", control, percent)
    return True


def _find_control() -> Optional[str]:
    try:
        output = subprocess.run(["amixer", "scontrols"], capture_output=True, text=True, timeout=5).stdout
    except (OSError, subprocess.SubprocessError):
        return None
    # Lines look like: Simple mixer control 'PCM',0
    available = {line.split("'")[1] for line in output.splitlines() if "'" in line}
    return next((c for c in MIXER_CONTROLS if c in available), None)

# One decoder per format. `aplay` comes with alsa-utils and plays WAV with nothing else installed;
# MP3 needs a decoder, and `mpg123` is the small standard one (`setup.sh` installs it). If apt is not
# an option on a given board, the way out is the app sending WAV instead of MP3 — hence both.
PLAYERS = {
    ".mp3": ["mpg123", "-q"],
    ".wav": ["aplay", "-q"],
}


def command_for(path: str) -> Optional[list]:
    """The command that plays this file, or None when nothing on this board can.

    Split out and pure so the mapping is testable on the Mac, where neither binary exists: what
    breaks in practice is choosing the wrong decoder for an extension, and that is checkable without
    a speaker.
    """
    player = PLAYERS.get(Path(path).suffix.lower())
    if player is None:
        return None
    return [*player, path]


class Player:
    """Plays files on the device's speaker, one at a time."""

    def __init__(self) -> None:
        self._process: Optional[subprocess.Popen] = None
        self._queue: queue.Queue = queue.Queue()
        self._queue_lock = threading.Lock()
        self._worker: Optional[threading.Thread] = None
        # Guards `_process` and `_generation`. `stop` comes from the BLE loop (`hush`), the clips
        # start on the audio worker and the readings on the HTTP thread: unguarded, a clip the worker
        # was launching while `stop` ran was never stopped — the board talking over the phone it had
        # just been told to yield to (2026-10-06).
        self._process_lock = threading.Lock()
        # Bumped by every `stop`. A clip dequeued before a stop must not start after it.
        self._generation = 0
        # Reported once, at startup, because it is the difference between "the audio did not arrive"
        # and "the audio arrived and there was nothing to play it with" — and on a device with no
        # screen the log is the only place anyone can tell them apart.
        available = {ext: shutil.which(cmd[0]) is not None for ext, cmd in PLAYERS.items()}
        log.info(
            "audio: %s",
            ", ".join(f"{ext} {'yes' if ok else 'NO'}" for ext, ok in available.items()) or "no players",
        )
        if not any(available.values()):
            log.warning("audio: no player installed; readings will arrive and not be heard")

    def play(self, path: str) -> None:
        """Start playing `path`, interrupting whatever was playing. Returns immediately."""
        command = command_for(path)
        if command is None:
            log.warning("audio: nothing can play %s", path)
            return
        self.stop()
        try:
            with self._process_lock:
                # Output to DEVNULL: mpg123 and aplay write progress to stderr, and at one line per
                # reading the journal would be mostly theirs.
                process = subprocess.Popen(command, stdout=subprocess.DEVNULL, stderr=subprocess.DEVNULL)
                self._process = process
        except (OSError, subprocess.SubprocessError) as exc:
            # Typically FileNotFoundError: the decoder is not installed. It is a warning and not a
            # raise because the caller is an HTTP handler answering the phone.
            log.warning("audio: could not play %s: %s", path, exc)
            return
        log.info("audio: playing %s (pid %d)", path, process.pid)

    def play_sequence(self, paths: list) -> None:
        """Play these files one after another, without cutting each other off. Returns immediately.

        Two lessons from the board (2026-09-15). `aplay a.wav b.wav` fails to reconfigure the device
        for the second file ("Unable to install hw params") and only the first is heard, so there is
        one process per file. And a bus announcement is two or three clips in a row ("a bus is
        coming", "115", "Luis Braille"): `play` would have each one kill the previous.
        """
        if not paths:
            return
        with self._queue_lock:
            for path in paths:
                self._queue.put(str(path))
            if self._worker is None or not self._worker.is_alive():
                self._worker = threading.Thread(target=self._play_queued, name="audio", daemon=True)
                self._worker.start()

    def _play_queued(self) -> None:
        while True:
            # Empty-check and exit under the same lock `play_sequence` enqueues under. Outside it, a
            # clip queued between this worker finding the queue empty and returning saw a live worker,
            # started none, and was never played (2026-10-06).
            with self._queue_lock:
                try:
                    path = self._queue.get_nowait()
                except queue.Empty:
                    self._worker = None
                    return
                generation = self._generation
            command = command_for(path)
            if command is None:
                log.warning("audio: nothing can play %s", path)
                continue
            try:
                with self._process_lock:
                    if generation != self._generation:
                        continue  # stopped after this clip was dequeued: it is not to be heard
                    process = subprocess.Popen(command, stdout=subprocess.DEVNULL, stderr=subprocess.DEVNULL)
                    self._process = process
            except (OSError, subprocess.SubprocessError) as exc:
                log.warning("audio: could not play %s: %s", path, exc)
                continue
            process.wait()

    def stop(self) -> None:
        """Silence whatever is playing, and drop whatever was queued behind it."""
        while True:
            try:
                self._queue.get_nowait()
            except queue.Empty:
                break
        with self._process_lock:
            self._generation += 1
            process, self._process = self._process, None
        if process is None or process.poll() is not None:
            return
        log.debug("audio: interrupting pid %d", process.pid)
        try:
            process.terminate()
        except OSError:
            pass
