juanlu-a/viro_vision/(commit log)

2026-07-09 chore: scaffold ViroVision monorepo structure
    Set up the top-level monorepo covering the three project pillars, each with a
    README describing its scope and status:
    - app/ React Native (Expo) mobile app
    - hardware/ Raspberry Pi Zero 2 W + Coral TPU + Camera Module 3 device
    - ml/ YOLO11 detection, OCR, Edge AI (TFLite)
    - docs/ thesis deliverables + architecture
    Add a root README mapping the pillars and the project's guiding principles
    (accessibility as a hard requirement, offline-first, low-cost/portable), and a
    root .gitignore covering Node, Python, and ML datasets/weights.
2026-07-09 docs: add ViroVision knowledge skill
    Add a project-level Claude Code skill capturing the thesis context so future
    sessions load it automatically:
    - SKILL.md project overview, the two use cases, timeline, the three
    pillars, cross-cutting constraints (Spanish, accessibility,
    offline-first), git conventions, and open PENDIENTE items
    - references/app.md RN/Expo, New Architecture, accessibility API + Mascetti
    et al. (2020) strategy, BLE, dual-channel audio, offline-first
    - references/hardware.md component selection rationale + two comms channels
    - references/ml.md YOLO11, OCR, Edge AI / on-device inference
    Includ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
2026-07-09 docs: add architecture decision records (ADR 0001, 0002)
    - ADR 0001 Offline-first: essential recognition (detection, OCR, audio) must
    work with no internet; the model runs locally (on-device or bundled on the
    phone), never a cloud inference API.
    - ADR 0002 Backend & auth: Supabase as the online account layer (Google login,
    profile, sync, model-file hosting), strictly separated from the offline core;
    a signed-in user stays signed in offline.
    Add an ADR index listing both, plus thesis decisions to backfill.
2026-07-09 feat(app): scaffold accessibility-first React Native app
    Bootstrap the ViroVision mobile app with Expo (SDK 57, RN 0.86, React 19,
    TypeScript, New Architecture) and Expo Router, reshaped from the starter
    template into a domain-oriented, accessibility-first structure.
    Screens (standard RN components with explicit accessibility labels/roles/hints,
    48dp touch targets, live regions):
    - index Home: navigation + working text-to-speech (expo-speech)
    - connect BLE device connection with a live connection state machine
    - settings account section (Google sign-in/out) via the online layer
    Domain layers:
    - features/recognition transport-agnostic detection/OCR model + ES formatting
    - features/d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
2026-07-10 ci: commit expo-env.d.ts so tsc resolves Expo ambient types in CI
    CI typecheck failed with TS2882 (cannot find declarations for '@/global.css').
    The Expo starter gitignores expo-env.d.ts and relies on it being auto-generated
    by `expo start`, but CI runs `tsc` right after `npm ci` with no generation
    step, so the file — and Expo's ambient `*.css`/image type declarations — is
    absent. Un-ignore and commit it (stable content: a reference to expo/types).
2026-07-10 ci(eas): add eas.json build/update profiles and enablement docs
    Add app/eas.json with development / preview / production build profiles, each
    bound to a matching EAS Update channel (appVersionSource: remote):
    - preview builds an iOS simulator app (no Apple account required) so the native
    build can be validated before the Apple Developer account exists
    - production targets device builds (needs Apple credentials)
    Update docs/ci-cd.md with the channel mapping and the one-time interactive setup
    (eas login / init / update:configure, EXPO_TOKEN secret, EAS_ENABLED variable).
    Note: eas init / update:configure and the EXPO_TOKEN secret still require the
    Expo account login and are done interactiv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
2026-07-10 feat(app): wire Supabase Google auth (OAuth web redirect)
    Replace the auth stub with a real @supabase/supabase-js client for the online
    account layer (ADR 0002), env-gated so the app still runs with no backend:
    - config.ts read EXPO_PUBLIC_SUPABASE_URL / _ANON_KEY; isSupabaseConfigured
    - supabase.ts memoized RN client (AsyncStorage session persistence, url
    polyfill, detectSessionInUrl:false); returns null when unconfigured
    - authClient.ts Google OAuth web-redirect flow: signInWithOAuth -> browser ->
    exchangeCodeForSession; getSession / signOut / onAuthStateChange
    - client.ts getSupabaseAuthClient() returns the real client when configured,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
2026-07-14 docs: add project status & session handoff
    Capture current state so the project can be continued from within the repo:
    project overview, repo layout, key decisions (ADRs, offline-first, Supabase
    OAuth), stack, per-pillar status, pending interactive setup (EAS/Supabase/iOS),
    and the next-steps options.
    Flags that main currently has only the scaffold (#1): the stacked PRs #2-#4
    merged into intermediate branches, so CI/CD, EAS, and Supabase live on
    feat/supabase-auth and still need consolidating into main.
2026-07-14 docs: mark main consolidation complete in status doc
    PR #5 merged CI/CD, EAS, and Supabase into main and the stale feature branches
    were deleted. Replace the 'main is missing work' warning with the current state
    (everything in main, CI green), keeping a short history note.
2026-07-19 feat(app): switch auth to Supabase email + password (drop Google/OAuth)
    Replace the Google OAuth web-redirect login with Supabase native email auth per
    the updated decision (see ADR 0002 update):
    - authClient.ts: signInWithEmail (signInWithPassword) + signUpWithEmail (signUp);
    removed the OAuth flow (WebBrowser / expo-auth-session / exchangeCodeForSession)
    - client.ts: interface + offline-safe stub updated to the email methods
    - useAuth.ts: expose signIn / signUp / signOut (+ signing-in and confirm-email states)
    - settings.tsx: accessible email + password form (labels/hints, 48dp inputs)
    - i18n: email/password strings; drop the Google string
    - uninstall expo-auth-session (no longer used)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
2026-07-19 docs: add session log and roadmap
    - docs/SESSION-LOG.md: chronological history of the work (kickoff → scaffold →
    CI/CD → EAS → Supabase → main consolidation → roadmap → email/password auth →
    iOS simulator blocker), so the project history lives in the repo.
    - docs/ROADMAP.md: the approved continuation plan (Track A app foundation +
    Track B ML/hardware, own design system, deferred recognition, email auth).
2026-08-11 feat(app): redesign — green/black design system, iOS tabs, no login (#9)
    Full UI overhaul, accessibility-first and minimalist, and the app opens directly
    (no login) per the team + tutor decision.
    - Design system (constants/theme.ts): green + black (dark, default) + clean white
    light mode; semantic tokens, radii, spacing; WCAG-AA contrast in both.
    - Navigation: iOS bottom tab bar (expo-router Tabs) — Inicio / Dispositivo /
    Ajustes — Ionicons, theme-aware; screens render large titles. Opens directly to
    the tabs; NO login gate (core is offline-first; Apple doesn't require login).
    - Account layer (Supabase email auth + AuthProvider) is ARCHIVED, not deleted:
    present in the repo bu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
2026-08-11 Dev build en iPhone + benchmark de latencia contra modelo de visión en la nube (#10)
    * docs: reunión con el tutor + nube como acelerador opcional (ADR 0001)
    Registra la reunión del 2026-08-10 sobre integración de modelo y performance
    en un nuevo docs/REUNIONES-TUTOR.md, y enmienda ADR 0001 con la postura
    acordada: la nube pasa a acelerador opcional y lo local queda como fallback
    garantizado. El requisito "funciona sin internet" no cambia; lo prohibido
    sigue siendo la nube como único camino.
    También deja asentado que Gemma no corre en la RPi Zero 2 W (~0.5 GB de RAM)
    y que iOS vs. Android sube a decisión bloqueante.
    * feat(app): bundle identifier fijo + guía de dev build en iPhone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
2026-08-12 Respetar la cuota de Gemini antes de pedir, no después de fallar (#11)
    * fix(vision): respetar la cuota antes de pedir, no después de fallar
    El tier gratuito de Gemini admite 20 requests por minuto **por modelo**, y la app
    las topaba todo el tiempo: cada medición gastaba 1 calentamiento + N corridas, y
    el calentamiento se repetía aunque no hubiera cambiado nada.
    - Limitador de ventana móvil por modelo (17 de 20, con margen para lo que el
    servidor ya contó y nosotros no). Espera con aviso en vez de fallar, y espera
    ANTES de arrancar el cronómetro para no contaminar la latencia medida.
    - El calentamiento se reusa mientras no cambien modelo, foto ni modo: era una
    llamada por medi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
2026-08-12 Manual de marca v1.0: tipografía, símbolo por tema y paleta (#12)
    * fix(app): estructura de encabezado consistente en todas las pantallas
    Inicio mostraba el símbolo de marca y las demás pantallas no, así que sus
    títulos arrancaban pegados al borde superior y la app se sentía descosida
    entre pestañas.
    El símbolo pasa al propio ScreenHeader con tres variantes: `large` en Inicio,
    `small` en el resto, y `none` en la pantalla de desarrollo, que ya tiene el
    header nativo arriba y amontonaría. Poniéndolo en el componente en vez de en
    cada pantalla, la estructura queda garantizada: título y subtítulo caen a la
    misma altura en todas las que comparten variante, y agregar una pantalla
    nu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
2026-08-12 docs(skill): convenciones y decisiones del repo, y corregir lo desactualizado (#13)
    La skill del proyecto cubría el dominio de la tesis pero no cómo se trabaja acá,
    y tenía afirmaciones que contradecían decisiones ya tomadas: `references/app.md`
    y `references/ml.md` seguían diciendo "never a cloud API" y proponiendo
    TFLite/ONNX/ExecuTorch, cuando ADR 0001 fue enmendado y ADR 0004 eligió LiteRT-LM.
    Un agente que leyera eso hoy tomaba decisiones contra las vigentes.
    - `references/convenciones.md` (nuevo): stack y comandos, la regla de verificar
    los docs versionados de Expo, CNG y config plugins, estructura de `src/`, las
    dos formas de servicio y cuándo usar cada una, reglas de fro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
2026-08-13 Spike de visión local, parte 1: sonda, carga de modelos y firma reproducible (#14)
    * spike(ondevice): sonda de viabilidad del runtime local, sin descargar modelo
    Primer paso del ADR 0004. La pregunta más barata primero: ¿el módulo nativo
    enlaza contra RN 0.86 / New Architecture, y cuánta memoria da este teléfono?
    Bajar 2,59 GB para descubrir que el codegen de Nitro no enlazó sería pagar el
    paso caro para responder el barato.
    - `react-native-litert-lm@0.6.0` + `react-native-nitro-modules@0.36.5`. El
    xcframework de iOS (82 MB) lo baja un postinstall desde el release de Google;
    verificado que llegó, porque si falla, falla en silencio.
    - `services/ondevice/`: catálogo y sonda. Ap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
2026-08-13 UI: scroll estable, botones que se leen como botones y selector de tema compacto (#15)
    * fix(ui): scroll, botones que se leen como botones y selector de tema compacto
    - **Scroll.** iOS ajusta solo el inset del primer ScrollView dentro de un
    navigation controller. Con el header nativo visible eso se sumaba al safe-area
    que ya aplicaba `SafeAreaView`: el inset se contaba dos veces y el sistema
    "corregía" saltando el scroll hacia arriba mientras se hacía scroll. Se apaga
    el ajuste automático y los insets los manejamos nosotros.
    - **Los `ghost` no se leen como botones**: texto verde suelto, sin borde ni
    relleno. Los de elegir modelo, backend y abrir las pantallas de medición pasan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
2026-08-13 Tailwind en nativo (NativeWind), con una sola paleta (#16)
    * spike(ui): Tailwind en nativo con NativeWind, con una sola paleta
    Expo SDK 57 documenta NativeWind como la forma de usar Tailwind en iOS/Android.
    No toca nada nativo —es Babel y Metro— así que se revierte con git sin
    recompilar.
    Las dos decisiones que hacían falta para que no empeore lo que veníamos de
    arreglar:
    1. **Una sola paleta.** La tabla se movió a `constants/colors.js`, JavaScript
    plano, porque `tailwind.config.js` es CommonJS y también la necesita. La
    consumen `theme.ts` (con tipos) y Tailwind. Si cada uno tuviera su copia,
    `bg-surface` y el token se separarían sin que nadie lo note y
    `theme.test.t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
2026-08-13 Spike de visión local, parte 2: OCR, ExecuTorch y el cierre (#17)
    * fix(ondevice): copiar el modelo a la app, o la conversación no se puede crear
    LiteRT-LM pone su caché compilada en la carpeta del **propio modelo**:
    // Cache dir set to parent directory of model path
    let cacheDir = (modelPath as NSString).deletingLastPathComponent
    Un archivo elegido de otra app se puede leer pero no escribir al lado. El motor
    se creaba bien —por eso el error llegaba tarde— y después fallaba al armar la
    conversación, con un mensaje que no menciona permisos por ningún lado:
    "Failed to create conversation context". Es exactamente la optimización que
    había elegido para ahorrar la copia la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
2026-08-23 docs: decisiones de la reunión de equipo — pipelines por caso de uso, botones y métricas (#18)
    * docs: las decisiones de la reunión de equipo — pipelines por caso de uso, botones y métricas
    - ADR 0006 (Proposed): bondis local con la Coral TPU como preprocesadora
    (detección → recorte del banner → OCR); supermercado LLM con visión,
    pendiente entre Gemma 3 1B local y Gemini Flash, con la restricción de
    gratuidad para el usuario. Datasets de evaluación (recall/precision/
    accuracy/F1) como la forma de medir precisión.
    - ADR 0007 (Proposed): botones físicos y modos de operación (1 click
    ómnibus, 2 clicks supermercado, click largo a esperando). Primer
    diagrama del r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
2026-08-23 Los modos de operación de ADR 0007 en Inicio: ómnibus local, supermercado nube o local (#19)
    * feat(app): el lector de carteles pasa a Inicio; Ajustes vuelve a ser configuración
    El lector vivió en una pantalla de desarrollo mientras fue un experimento. Con
    el spike cerrado (docs/spike-vision-local.md), esconderlo detrás de Ajustes era
    hacerle pedir permiso al usuario para usar la app.
    - **Inicio**: elegí un camino (OCR local / modelo local / nube), elegí una foto,
    y la app anuncia la línea **en voz alta** — la voz es la interfaz, la pantalla
    es el registro. Cada camino prepara su modelo la primera vez, avisando cuánto
    baja; prepararlos todos al arrancar sería pagar descar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
2026-08-23 fix(ui): el scroll termina por encima del navtab, y tirar hacia abajo refresca (#20)
    - **El final del contenido quedaba escondido detrás de la barra flotante.** La
    barra de iOS 26 no es parte del safe area clásico, pero sí del
    `adjustedContentInset` que UIKit calcula por scroll view: los insets pasan a
    manejarse con `contentInsetAdjustmentBehavior="automatic"` y SafeAreaView deja
    de aplicar el borde superior en modo scroll en iOS — aplicarlo dos veces era
    el bug del scroll que saltaba, así que este arreglo también reemplaza a aquel
    parche en vez de apilarse encima. Android conserva el safe area clásico: ahí
    `automatic` no existe y la barra no flota sobre el contenido.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
2026-08-29 TestFlight desde Xcode, sin EAS: scripts/testflight.sh y docs (#22)
    * feat(eas): el camino a TestFlight — perfiles de dispositivo, submit y docs
    Con el Apple ID del proyecto inscripto en el Apple Developer Program
    (Individual, team VPNXQ8K2P8 conservado), el canal del equipo y de los
    testers pasa a ser TestFlight en vez del dev build por cable que
    caducaba a los 7 días. eas.json gana development en dispositivo,
    development-simulator y submit.production con appleId/appleTeamId;
    production ya era store con autoIncrement remoto. El workflow manual de
    EAS Build suma el perfil development y --auto-submit opcional.
    Los pasos que piden credenciales (eas init, build, submit) quedan
    documentados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
2026-08-29 feat(ci): cada merge a main sube un build a TestFlight; builds beta desde cualquier rama (#23)
    Runner macOS de GitHub (gratis: el repo es público) con el mismo script
    que se usa en el Mac, más la distribución por API: esperar el
    procesamiento de Apple, cargar 'qué probar', asignar al grupo y enviar a
    Beta App Review. Dos grupos externos con link público, porque el equipo
    no quiere agregar testers a mano: 'Testers ViroVision' recibe main (la
    versión oficial) y 'Beta ViroVision' lo que se dispare a mano desde una
    rama. scripts/asc.mjs firma el JWT ES256 con node:crypto para no sumar
    dependencias por tres llamadas.
2026-08-29 fix(ci): el contexto runner no existe en el env del job — la ruta de la key se fija en el paso (#24)
    GitHub rechazaba el workflow entero al parsearlo, sin correr nada.
2026-08-29 fix(ci): 'otro build en revisión' no es una falla de la pipeline (#25)
    Apple admite un solo build por versión en Beta App Review a la vez; el
    primer run automático chocó con el build manual del mismo día. El build
    ya quedó subido y en el grupo: se registra y se sigue.
2026-08-30 feat(release): dos ramas, dos apps — staging publica ViroVision β y main la oficial (#26)
    El equipo quiere la versión en prueba y la oficial instaladas a la vez
    en el mismo teléfono. iOS no instala dos builds del mismo bundle, así
    que la β es otra app para Apple: app.config.js con APP_VARIANT=beta
    cambia bundle (.beta), nombre ('ViroVision β') e ícono (franja BETA con
    los colores de marca); todo lo demás sigue saliendo de app.json.
    staging pasa a ser la rama por defecto: todos los PRs van ahí y cada
    merge publica la β; main es producción y sólo recibe PRs staging → main,
    que publican la oficial. El workflow resuelve la variante por rama, corre
    lint/typecheck/tests antes de c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
2026-08-30 fix(ci): el env de un job no puede leer env — la variante se calcula una sola vez a nivel workflow (#27)
    GitHub rechazaba el workflow al parsearlo, como con runner.temp.
2026-08-30 Una sola app, dos grupos: staging a prueba interna, main al link público (#29)
    * feat(ci): la β va a prueba interna — los devs la reciben en minutos, sin Beta App Review
    Cada app nueva exige su propia revisión de Apple para testers externos;
    la β no la necesita: sus únicos testers son los devs, que ya son usuarios
    de App Store Connect. El grupo interno con hasAccessToAllBuilds recibe
    todo build procesado sin asignar ni enviar nada. La oficial sigue externa
    con link público; promover a producción es el PR staging → main.
    * feat(ci): una sola app, dos grupos — staging a prueba interna del equipo, main al link público
    Se descarta publicar la β como app aparte (bundle .beta): s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
2026-08-30 fix(ci): un solo build visible por grupo de TestFlight (#30)
    Pedido del equipo: no ver tres builds. El interno muestra sólo el último
    de staging; el externo el nuevo más el último aprobado (para que el link
    no quede vacío mientras Apple revisa) y lo que esté en revisión. El
    grupo interno se crea sin hasAccessToAllBuilds, que Apple no deja
    cambiar después.
2026-08-30 feat(android): Google Play testing por el mismo camino que TestFlight (#31)
    Un dev del equipo tiene Android. staging → internal testing (sin
    revisión, minutos), main → closed testing con link de opt-in. El Mac no
    tiene Java: la upload key es un PKCS12 de openssl y el build corre sólo
    en el runner Linux, con la firma inyectada por propiedades de Gradle y
    versionCode = minutos desde 1970. Subida por la Google Play Developer
    API con service account, sin dependencias. Gateado con PLAY_ENABLED
    hasta que exista la cuenta.
2026-08-30 chore(app)!: cierre del spike de visión local — un solo runtime, supermercado en la nube (#34)
    Ómnibus queda con el OCR local (en el producto, sobre el banner que la
    TPU recorta; ADR 0006) y supermercado va a la nube; sin internet o sin
    clave, avisa — excepción acotada a ADR 0001, escrita en la actualización
    2026-08-30 de ADR 0006, pendiente de cerrar evaluando Gemma 3 1B como
    fallback local.
    Se retiran el laboratorio del spike (LiteRT-LM, Gemma multimodal por
    ExecuTorch, benchmark de nube, sonda) y sus dependencias; queda un solo
    runtime nativo (ExecuTorch, sólo OCR). expo-file-system se conserva: lo
    importa el resource fetcher que descarga los pesos del OCR. El código
    retirado v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
2026-08-30 feat(reader): el modelo de nube del supermercado se elige en Inicio (#35)
    Un modal accesible calcado del selector de tema (button cuya etiqueta
    dice qué modelo rige; radiogroup con checked), controlado por props para
    que la decisión viva en un hook testeable. La preferencia se guarda en
    el teléfono y se revalida contra los modelos disponibles del build: un
    id guardado de un proveedor sin clave cae al default en vez de fallar en
    cada lectura. reconocerProducto recibe el modelo elegido; prompt y
    schema siguen siendo únicos por tarea para que cambiar de modelo compare
    modelos y no preguntas.
2026-08-30 docs: CLAUDE.md en la raíz — el contexto que toda sesión lee al arrancar (#37)
    Abrir una sesión nueva para una feature exigía saber que hay que invocar
    la skill virovision; un agente que no lo sabe trabaja sin las reglas
    (rama desde staging antes del primer edit, PRs a staging, sin co-autoría
    de IA). CLAUDE.md se carga solo al iniciar: lleva el resumen mínimo y la
    orden de leer la skill. De paso, convenciones.md gana el resumen de
    cómo se libera (staging → interno, release → link público) y corrige el
    chequeo de squash, que seguía apuntando a main.
2026-08-30 fix(ci): el log de xcodebuild se conserva y se muestra al fallar (#38)
    El | tail -3 se comió el error real del archive dos veces seguidas en el
    runner (exit 65 a los 30 segundos, sin una sola línea de causa). Ahora
    el log completo va a build/xcodebuild-*.log y al fallar se imprimen las
    últimas 80 líneas.
2026-08-30 fix(ci): el archive firma con distribución cloud — cada runner creaba un certificado de desarrollo (#39)
    La firma automática por defecto archiva con identidad de desarrollo, y
    en un runner efímero eso significa un certificado nuevo por corrida:
    la cuenta llegó al tope de Apple ('maximum number of certificates') y
    los builds de staging empezaron a fallar en 30 segundos. Se revocaron
    los 16 'Created via API' (el del Mac quedó) y con la API key presente
    el archive pasa a firmar con Apple Distribution, que es una sola,
    cloud, y se reusa entre runners.
2026-08-30 fix(ci): el archive va sin firmar en CI; firma el export con la distribución cloud (#40)
    Forzar Apple Distribution en el archive choca con la firma automática
    (Xcode lo rechaza como conflicto). El camino estándar de CI es archivar
    sin firmar y dejar que el export — que ya usa la distribución cloud —
    firme todo. En el Mac nada cambia.
2026-08-30 fix(ci): el export declara el teamID — un archive sin firmar no lo trae (#42)
    Desde #40 el archive en CI va sin firmar (CODE_SIGNING_ALLOWED=NO) y la firma
    quedó a cargo del export. Pero exportArchive con signingStyle automatic deduce
    el equipo DEL ARCHIVE, y un archive sin firmar no registra ninguno: el run
    33333218822 falló con 'error: exportArchive No Team Found in Archive'.
    El ExportOptions.plist ahora declara teamID, leído del pbxproj que genera el
    prebuild (plugins/withDevelopmentTeam.js), para que el ID siga viviendo en un
    solo lugar. En el Mac el archive va firmado y el teamID coincide: es inocuo.
2026-08-31 docs: cierre de sesión 2026-08-30 — CLAUDE.md y la saga de la firma en CI (#41)
    * docs: cierre de sesión 2026-08-30 — CLAUDE.md y la saga de la firma en CI
    Registro para la próxima sesión: el porqué de cada fix de firma (tail
    que escondía el error, certificados de desarrollo por runner, el
    conflicto de identidad forzada, archive sin firmar) y los open threads
    al día: validación del PR #40, Beta App Review, Google Play en
    verificación, Magalí pendiente.
    * docs: la saga de la firma termina en verde — teamID en el export (#42)
2026-08-31 feat(supermercado): tipo y marca por separado, y el modelo de nube se elige en el modo (#43)
    * feat(vision): la lectura de producto devuelve tipo y marca, y el default pasa a Flash Lite
    Tres cambios sobre el modo supermercado, con medición contra la API real detrás.
    `producto` mezclaba qué es el producto con de quién es; ahora son `tipo`, `marca` y
    `detalle`, separados. No es prolijidad de modelado: para quien no ve, el tipo decide si
    el producto sirve y la marca sólo cuál de los que sirven. Separados, el anuncio puede
    decir el tipo aunque la marca no se lea (y al revés), en vez de perder los dos porque el
    modelo no pudo completar un campo entero. La frase queda "arroz Saman, Blue P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
2026-09-01 docs: knowledgebase al día — link público vivo, fantasma del build 1, ciclo abrir/cerrar (#45)
    El pedido de fondo es no repetir contexto entre sesiones. CLAUDE.md ahora
    explicita el ciclo: al abrir, invocar la skill virovision; al cerrar cada
    sesión o ticket, actualizar SESSION-LOG (siempre), PROJECT-STATUS (si cambió
    el estado), la skill (si cambió cómo se trabaja) y ADRs (si hubo decisión).
    Lo aprendido en la sesión 2026-08-31→09-01 queda donde corresponde:
    - dev-build-ios.md: no expirar un build con Beta App Review pendiente (deja
    un fantasma que bloquea el slot por horas) y consultar el estado por build,
    no por listado con include.
    - PROJECT-STATUS: la review del release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
2026-09-01 docs: el diagrama de los tres casos, y por qué un proxy propio para las claves (#46)
    Guarda el diagrama que el equipo dibujó (`documents/logicas-casos-de-uso.pdf`) y lo
    transcribe a mermaid en `docs/architecture/README.md`, que es la fuente canónica: los
    tres flujos —ómnibus con modelo parcial en la Raspi, ómnibus con modelo completo, y
    supermercado contra un modelo en la nube— pasan a leerse en un diff y a renderizarse en
    GitHub. El PDF queda como registro de dónde salió la decisión, y el README de
    `documents/` dice cuál de los dos manda si difieren.
    ADR 0008 escribe la decisión de fondo: las claves de los modelos de nube salen del
    bundle a un proxy propio. El motivo es que `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
2026-09-02 feat(supermercado): la foto sale de la cámara, y se achica antes de subirla (#47)
    Hasta ahora el botón de leer abría la **fototeca**. Eso servía para probar, pero no era
    el flujo: en el diagrama acordado la foto la saca la placa del dispositivo y llega al
    teléfono por BLE/WiFi. Mientras no hay hardware, la cámara del teléfono ocupa ese lugar
    y el resto del camino es idéntico — que es lo que permite desarrollar y evaluar el modo
    supermercado hoy.
    Se usa la cámara del sistema vía `expo-image-picker`, no una vista propia con
    `expo-camera`: la UI nativa ya está resuelta para VoiceOver (obturador etiquetado,
    anuncios de encuadre), y la convención de accesibilidad de esta base prefi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
2026-09-02 feat(vision): cinco modelos de cuatro proveedores, y el tope de cuota deja de ser el de Gemini (#48)
    El selector de supermercado tenía dos proveedores porque ADR 0006 exigía que el modelo
    fuera gratuito para el usuario. Esa restricción cayó para el proyecto —se paga para
    poder comparar— y sigue vigente para el usuario final, que es lo que resuelve el proxy
    de ADR 0008. Entran OpenAI y Groq.
    Un solo módulo cubre los dos. OpenAI, Groq y cualquier vLLM hablan el mismo protocolo:
    POST /v1/chat/completions, Bearer, imagen como data URI en un content part image_url, y
    deltas en choices[0].delta.content. Escribir dos proveedores casi idénticos sólo crea dos
    lugares donde arreglar el mis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
2026-09-02 feat(vision): un proxy propio, para que la clave no viaje dentro del .ipa (#49)
    Implementa ADR 0008. `EXPO_PUBLIC_*` no es una variable de entorno que el binario lea al
    arrancar: es una constante compilada dentro del .ipa/.apk, y un `strings` sobre el bundle
    la devuelve. Con el tier gratuito de Gemini eso era una molestia; desde que hay link
    público de TestFlight y modelos pagos en el selector, es la tarjeta del proyecto.
    La función es un proxy TONTO a propósito. Recibe el cuerpo que el módulo de proveedor del
    cliente ya armó, le agrega la cabecera de autenticación desde los secrets y devuelve el
    body upstream sin tocarlo, stream SSE incluido. No interpreta la respuesta, no arma el
    re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
2026-09-02 feat(audio): la lectura además deja un mp3, apagado por defecto (#50)
    En el diagrama acordado el audio sale por el parlante del dispositivo, no por el del
    teléfono. `expo-speech` usa el motor TTS del sistema y no exporta a archivo, así que el
    .mp3 tiene que venir de un TTS de nube.
    Se usa el de OpenAI (gpt-4o-mini-tts): devuelve MP3 directo con la clave que el selector
    de modelos ya necesita, y sale por el mismo proxy sin tocar el servidor —/v1/audio/speech
    está en api.openai.com, que ya está en la allowlist. Ése es el rédito de haber validado
    por host y no por URL exacta. Quedan descartados Google Cloud TTS, porque una clave de AI
    Studio no tiene esa API habilitada (son proyectos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
2026-09-02 docs: cierre de sesión 2026-09-01 — el modo supermercado, entero (#51)
    Pone la knowledgebase al día después de los PRs #46 a #50.
    SESSION-LOG: la entrada de la sesión, con el porqué de cada decisión y no el diff —
    por qué el diagrama se versiona dos veces, por qué la cámara del sistema y no
    expo-camera, por qué se restringe el lado mayor y no el ancho al achicar, por qué gana
    Supabase por encaje y no por ser la mejor herramienta, por qué el Qwen 3.8 aunque el 3.6
    sea más rápido, y por qué el archivo de audio salió apagado. También queda registrada la
    deuda: los proveedores de OpenAI y Groq están escritos contra los docs y no contra la API
    real, que es lo contrario del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
2026-09-02 fix(vision): la cuota que llega por HTTP también es cuota, y el tope de Groq es por tokens (#52)
    Primera medición de los proveedores nuevos contra las APIs reales, con el código de la
    app y no una réplica. Los tres andan y los tres aciertan tipo, marca y detalle. Lo que
    encontró la medición es lo que arregla este PR.
    **El defecto.** La cuota no siempre llega como evento SSE: Groq devuelve HTTP 429 con
    cuerpo JSON ANTES de abrir el stream, y por ese camino se lanzaba VisionHttpError, que la
    UI no distingue. El usuario escuchaba "La nube no respondió" en vez de "Cuota agotada,
    reintentá en N s", con el dato de cuánto esperar llegando en el cuerpo y nadie leyéndolo.
    Es el mismo tipo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
2026-09-02 feat(vision): el selector queda en Luna y Groq, con la medición que lo justifica (#53)
    Cinco corridas espaciadas por modelo, con el código de la app contra las APIs reales,
    mismo prompt y mismo schema. Los datos crudos y el método quedan versionados en
    docs/mediciones/, que es carpeta nueva: el análisis y la decisión van en
    pruebas-y-decisiones.md —que es el borrador de la sección de la tesis— y los números que
    los respaldan viven aparte, para que la conclusión se pueda auditar y la medición
    repetir sin reconstruirla de memoria.
    La precisión no separó a los modelos: 15/15 corridas correctas en los tres campos. Lo
    que separa es la latencia y, dentro de la latencia, la dispersi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
2026-09-02 docs: cierre 2026-09-02 — la sesión en que medir cambió dos decisiones (#54)
    SESSION-LOG con la entrada de la sesión: el arnés que usa el código de la app y no una
    réplica, los tres proveedores verificados, los tres bugs que sólo aparecen midiendo, y
    las dos justificaciones que la medición desmintió (la del razonamiento y la del techo de
    1024 px). Queda registrado también que la campaña del 30/08 estaba mal reportada, porque
    esa es la lección que aplica al resto de la tesis y no sólo a este módulo.
    PROJECT-STATUS al día con el selector de dos modelos y el link a docs/mediciones/.
    Los Open threads se reordenan: las claves ya no son pendiente, y sube al primer lugar el
    datas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
2026-09-02 fix(ci): un build sin ningún modelo de nube tiene que fallar antes, no descubrirse al abrir la app (#55)
    El 2026-09-02 salió un build a TestFlight con el modo supermercado muerto. No fue una
    fuga de claves: al sacar Gemini del selector, el único secret de proveedor que tenía el
    repo dejó de corresponder a un modelo del registro, y availableModels() quedó en vacío.
    La app degradó como debía —dijo "no configurado" y el modo ómnibus siguió leyendo— y esa
    es justamente la trampa: la degradación elegante es correcta en runtime y es un problema
    en el pipeline. Un build que no puede cumplir la mitad de su función no debería tardar
    media hora en decirlo, ni que haya que abrirlo pa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
2026-09-02 docs(supabase): el proxy quedó desplegado; los builds ya no llevan ninguna clave (#56)
    Cierra el pendiente (b) de ADR 0006 en la práctica, no sólo en el diseño.
    El proyecto de Supabase ya existía desde el 18/07 —se había creado para la capa de cuenta
    de ADR 0002 y nunca se llegó a usar: 0 usuarios, 0 tablas, 0 buckets— y estaba pausado
    por inactividad. PROJECT-STATUS lo daba por inexistente y estaba desactualizado.
    Se cargaron las tres claves disponibles como secrets del servidor y se verificó de punta a
    punta con el código de la app y la clave del cliente EN VACÍO, que es la prueba de que la
    pone el servidor y no el bundle. Las cuatro guardas responden: destino ajeno con pro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
2026-09-02 fix(audio): el test de síntesis medía el entorno, no el código (#57)
    El build de TestFlight falló apenas quedó configurado el proxy, y el motivo es un test
    que yo escribí mal.
    `sintesis.test.ts` afirmaba "sin proxy configurado sale directo a OpenAI" y leía el proxy
    del entorno. En local pasaba porque jest no carga `.env`; en el job de publicación
    EXPO_PUBLIC_VISION_PROXY_URL sí está en el entorno, así que el pedido salía por el proxy,
    el cuerpo pasaba a ser el sobre `{provider, url, body}` y las aserciones sobre `body.input`
    y sobre la URL caían. Un test que cambia de resultado según dónde corre no está
    verificando el código.
    El arreglo es hacer el proxy inyectable, igual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
2026-09-02 docs: cierre final 2026-09-02 — el proxy en producción y las lecciones de los dos fallos (#58)
    Completa el registro de la segunda mitad del día (PRs #55 a #57), que había quedado fuera
    del cierre anterior porque se escribió antes de desplegar.
    Lo que se documenta no es la cronología sino las tres cosas que enseñaron dónde no
    estábamos mirando:
    La degradación elegante es correcta en runtime y es una trampa en el pipeline. Un build
    salió con el modo supermercado muerto y la app hizo lo correcto —avisó y no rompió—, y
    justamente por eso nadie se enteró hasta abrirla. El chequeo que lo previene compara lo
    que efectivamente se desincronizó: los proveedores del REGISTRO contr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
2026-09-04 feat(ajustes): el selector de modelo de supermercado se muda a Ajustes (#59)
    Elegir el modelo es un ajuste: se toca una vez, no en cada lectura, y en
    Inicio competía por atención con la acción principal. En Ajustes va sin
    rótulo ni texto alrededor: el disparador ya se anuncia como "Modelo
    seleccionado: <modelo>" y el menú como "Seleccionar modelo", así que un
    encabezado sólo repetiría lo que el lector de pantalla dice.
    El hook useModeloSupermercado pasa a Provider, montado en el layout raíz.
    No es refactor de gusto: con el selector en Ajustes y la lectura en Inicio,
    dos instancias del hook habrían tenido cada una su useState, y elegir un
    modelo se habría visto aplicado sin estarl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
2026-09-05 feat(enlace): ADR 0003, daemon BLE de la placa y medición de transferencia (#60)
    * feat(hardware): daemon BLE de la Zero 2 W con transferencia medible
    Primer código del pilar de hardware. Un solo proceso Python (bluez-peripheral
    sobre BlueZ) que anuncia «ViroVision», expone el perfil GATT (modo, control,
    evento, transferencia, estado) y manda un payload en chunks por notificaciones,
    con la cámara real detrás de picamera2 o bytes sintéticos si no hay cámara.
    Existe para el spike del ADR 0003: la foto que la app sube hoy a la nube pesa
    ~53 KB, y si baja por BLE en menos de 2 s no hace falta WiFi. Nadie midió el
    throughput BLE real de esta placa hacia un iPhone; este daemon es la pun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
2026-09-05 feat(enlace): plan B del ADR 0003 — la foto por HTTP sobre WiFi y punto de acceso en la placa (#61)
    * feat(enlace): plan B del ADR 0003 — la foto por HTTP sobre WiFi y punto de acceso acotado en la placa
    Medido el 2026-09-05: por BLE los 53 KB tardan 4,5 s; por WiFi sobre la misma
    radio, 46 ms. BLE queda como plano de control y esto trae el payload.
    Placa: servidor HTTP stdlib en un hilo (GET /salud, /medir/<bytes>,
    /fotos/ultima; POST /audio), IP y puerto publicados en la característica
    estado, y un punto de acceso con NetworkManager que se enciende por BLE
    siempre por tiempo acotado: la Zero 2 W tiene una sola radio y con el AP
    arriba pierde su red y el SSH, así que si la app no lo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
2026-09-07 docs(hardware): batería y alimentación — LiPo 103450 2000 mAh y Waveshare UPS HAT (C) (#64)
2026-09-07 docs(hardware): la alimentación queda decidida — el equipo compró la Waveshare UPS HAT (C) (#65)
2026-09-07 feat(enlace): el flujo completo sin configurar nada — BLE automático, WiFi de la placa solo, foto y audio por WiFi (#62)
    * feat(enlace): el flujo completo sin configurar nada — BLE automático, WiFi de la placa solo, foto y audio por WiFi
    Cierra el híbrido del ADR 0003 de punta a punta. La placa expone sus
    credenciales de AP por la característica wifi y enciende el AP al activarse
    un modo (lo apaga en esperando, siempre con tope de tiempo). La app tiene un
    DispositivoProvider compartido: conecta por BLE al arrancar y reconecta con
    espera creciente, se une al WiFi de la placa con react-native-wifi-reborn
    cuando ella enciende el AP (sin que el usuario toque Ajustes), sincroniza el
    modo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
2026-09-07 feat(placa): botón físico en GPIO 5 — 1 click ómnibus, 2 supermercado, largo sale del modo (#67)
    Era el punto 1 de "qué falta" del README de la placa (ADR 0007). `boton.py` separa el
    reconocimiento del gesto (`DetectorDeClicks`, puro, con el temporizador inyectado: se testea
    entero en la Mac) de qué hace cada gesto, que ya vivía en `modos.py`.
    Dos decisiones que importan para un usuario ciego, y que están en los tests: el click largo no
    cuenta además como click al soltar —si contara, salir de un modo lo metería en otro en el mismo
    gesto— y se actúa al cumplirse el umbral, no al soltar, porque el anuncio de audio tiene que llegar
    cuando el gesto se cumple.
    Los callbacks de g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
2026-09-09 refactor(app): la app deja de ser su propia consola (#68)
    Cuatro pedidos con un mismo hilo: la app llevaba encima el andamio con el que se
    construyó, y con la placa andando y los logs en Supabase el andamio ya no sostiene
    nada.
    Fuera la información técnica de las pantallas. Era el pendiente anotado el
    2026-09-07 al desplegar la tabla `eventos`: de Inicio se van el texto crudo del
    OCR, el modelo que respondió, el tiempo, la ruta del .mp3 y la vista previa de la
    foto con sus bytes y milisegundos; de Dispositivo, el volcado de telemetría, la
    dirección en la red y el firmware. Queda lo que el usuario usa o necesita saber.
    Un 192.168.4.1:8080 no le dice nada a quien no ve la pantalla, y er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
2026-09-09 feat(telemetria): la app registra en `eventos` lo que le pasa (#69)
    El 08/09 la información técnica salió de las pantallas y quedó un hueco: el
    diagnóstico no estaba ni ahí ni en la nube. Esto lo cierra.
    Averiguar el contrato fue la mitad del trabajo, y la lección. La función
    `telemetria` estaba desplegada desde el 07/09 pero escrita en el dashboard y sin
    versionar: sondeándola se sabía que aceptaba {telefono, sesion, eventos}, pero
    todo evento contestaba {"guardados":0} sin decir por qué. Hubo que bajarla para
    descubrir que cada evento necesita `tipo` y `momento`, y que sin ellos se descarta
    con status 200 — o sea que una app que arma mal el cuerpo se ve idéntica a una que
    an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
2026-09-09 fix(telemetria): esquema versionado, la cola deja de taparse, y lo rescatado de la rama huérfana (#70)
    * fix(telemetria): el esquema de `eventos` versionado, y un lote fallido deja de tapar la cola
    Tres cosas, todas salidas de abrir la base con la contraseña.
    El esquema queda versionado, pero NO escrito acá: el archivo venía de
    `feat/telemetria-supabase`, una rama del 07/09 sin PR y sin mergear que ya tenía
    la migración. Se recupera con su fecha original y se verificó contra la base real
    con `supabase db dump` — coincide campo por campo e índice por índice.
    Esa rama, además, ya hacía lo de los PRs #68 y #69 enteros: sacaba lo técnico de
    las pantallas y mandaba eventos a `eve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
2026-09-09 docs(telemetria): la tabla `eventos` queda con un solo vocabulario (#71)
    * docs(telemetria): la tabla `eventos` queda con un solo vocabulario
    Se borraron las ~28 filas en snake_case que había dejado el build manual de
    `feat/telemetria-supabase`, y la rama con ellas: una consulta que filtrara por
    `tipo` sin contemplar las dos formas habría mostrado de menos sin avisar, que es
    la peor forma de estar mal. La tabla arranca limpia.
    La sección de `docs/supabase.md` que explicaba cómo convivir con los dos
    vocabularios pasa a explicar por qué hay uno solo y qué lo sostiene: la unión
    cerrada de `tipos.ts`, para que no aparezca un tercero.
    * docs: el SESSION-LOG al día — tabla limpia y la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
2026-09-10 refactor: the whole codebase speaks English (ADR 0009) (#72)
    * refactor(app): the app pillar speaks English
    Identifiers, file names, comments and tests in the app move to English. What
    stays Spanish is what the user hears and reads: the values in `i18n/es.ts`, the
    supermarket prompt (its answer is spoken aloud) and the model labels shown in
    the selector. The i18n keys are English; the values are untouched.
    Wire-level renames that have to move together with the device and the Edge
    Functions, and do so in this same branch:
    - GATT characteristics modo/evento/transferencia/estado -> mode/event/
    transfer/status, and their JSON payloads (`{t:'start'|'end'|'mode'|'ap'|
    'error'}`, `batt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
    [__main__.py, ap.py, button.py, camera.py, core.py, emulator.py, gatt.py, http_server.py]
2026-09-10 docs: el pendiente de la microSD nombraba un archivo que no existe (+ cómo arranca la tarjeta) (#73)
    * docs: the microSD pending item named a file that does not exist
    Yesterday's note said the fix was to edit the systemd drop-in
    `10-sin-ap.conf`. That drop-in is not on the card: a boot-partition script
    (`/boot/firmware/modo-red.sh`, run by `virovision-modo-red.service`) writes it
    or deletes it depending on whether `/boot/firmware/SIN-AP` exists, and the card
    currently has no `SIN-AP` — so it is in product mode with no drop-in at all.
    A `sed` against that path would have matched nothing and left everyone believing
    the thing was fixed, which is worse than the note not existing. What actua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
2026-09-10 feat(device): a gesture names a mode, not a step — 1 click bus, 2 clicks supermarket, from anywhere (#74)
    Tested with the button soldered, the ADR 0007 machine did not hold. Clicks only counted from idle:
    inside a mode the short click was reserved "to trigger a reading" and switching from bus to
    supermarket needed a long press in between. In the hand that does not read as "a gesture is
    missing", it reads as the button being broken — and for someone who cannot see the screen, a
    control that sometimes answers is worse than a simpler one.
    Now 1 click is always bus and 2 clicks always supermarket, from any state; entering a mode leaves
    the previous one. The long press is still the way out.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
    [core.py, modes.py]
2026-09-10 docs: how the new daemon reached the board, and the three traps on the way (#75)
    Writes down the deployment of the ADR 0009 daemon, which closed the gap where
    the TestFlight app spoke the new protocol to a board still running the Spanish
    one. The three things that cost time are the point of the entry:
    - The renamed flag lived in TWO files, not one: `modo-red.sh` and also
    `instalar-daemon.sh`, which writes the same drop-in itself after installing.
    Only the first was known. Found because the new daemon's first start failed
    with `unrecognized arguments: --sin-ap`.
    - The `bootfs` tarball has to carry `raspi/` whole — the installer untars and
    then `mv raspi virovision`, so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
2026-09-10 docs: what actually unblocked "red apagada", and the debt it exposes (#76)
    The user did three things at once — force-quit the app, forget the ViroVision
    Wi-Fi network, and forget the Bluetooth device — and the flow came back. Which
    of the three did it is still not isolated, and the entry says so rather than
    picking one: naming a cause without measuring it would invent exactly the part
    someone will rely on later. What can be stated is that the set includes the
    remedy this codebase already documents (forgetting the BT device, which makes
    iOS drop its GATT cache) and that the scenario was the one that triggers it —
    the whole daemon had just been replaced and restarted with the app connect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
2026-09-10 feat(device): two clicks mean "read this", so the second one reads again (#77)
    In front of the shelf the user repeats the double click to read the next
    product, and nothing happened: the mode was already supermarket, so there was no
    transition, and the capture was keyed off the transition. Same complaint the
    previous ADR 0007 update fixed one level up — the button feels dead.
    The reading request stops being inferred from a state change and becomes an
    explicit signal. ADR 0007 had already left this open and predicted the cost
    ("exige que el dispositivo avise cada gesto y no sólo cada cambio de modo"), so
    the protocol grows one event: `{"t":"read","mode":N}` on `event`. Re-announcing
    the m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
    [core.py, modes.py]
2026-09-10 docs: the double-click reading, and the device README caught up two updates (#78)
    Records why the reading request stopped being inferred from the mode transition
    and became an explicit `{"t":"read"}` event — the question ADR 0007 had left
    open — along with the two cheaper alternatives that were rejected and why
    (re-announcing the mode is silently dropped and would speak over someone reading
    three products; having the device take the photo breaks ADR 0003's "the app
    pulls, the device never pushes").
    The device README was two updates behind and said the opposite of what the
    firmware does: its button table still required going through idle, and claimed
    short clicks inside a mode did nothin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
2026-09-10 feat(ci): an .aab cannot be installed on a phone, so build an .apk too (#79)
    Handing the app to somebody with an Android in front of you has no path today: the
    Play account does not exist (PLAY_ENABLED is unset, the service account is pending)
    and what android-play.yml produces is an .aab, a publishing format that Google
    re-splits per device and that a phone refuses to install.
    So this is the sideload sibling of the Play pipeline, and nothing more: the same
    runner, the same prebuild, the same versionCode = minutes since 1970, the same
    upload key already loaded as a secret — Gradle's assembleRelease instead of
    bundleRelease, and the resulting universal .apk left as an artefact of the run,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
2026-09-11 fix(app): the button has to work with the screen locked, which is the whole product (#80)
    * fix(app): the button has to work with the screen locked, which is the whole product
    Tested the way ViroVision is meant to be used —phone locked in a pocket, double
    click on the board's button— and nothing happened. No reading, no error, nothing
    on screen after unlocking. ADR 0003 §2 is built on that scenario, so this is not
    a rough edge.
    The first finding was our own mistake. The ADR said iOS background was off until
    spike 1 because the ble-plx plugin had `isBackgroundEnabled: false`. That flag
    never gated iOS: withBLE.js applies withBLEBackgroundModes(modes) unconditionally
    and the flag only a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
2026-09-11 feat(device): the reading the phone sends back is finally heard (#82)
    `/audio` accepted the MP3, wrote it to /tmp, answered 202 — and `__main__` never
    passed the `play` callable the HTTP server calls. So every supermarket reading
    reached the device and died there, in silence, with every layer reporting success.
    That is the worst shape a bug can have, and it is why test_audio.py exists.
    Three things the player does deliberately. It does not wait for the audio to finish:
    the caller is the handler answering the phone, and the app awaits that response, so
    holding it open for the length of the sentence would make the device look slow exactly
    while it is talking. A new reading interrupts the on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
    [__main__.py, audio.py]
2026-09-11 feat(app): choose where the reading is heard, the phone or the device (#83)
    The final device does not exist yet, so comparing the two output paths has to be
    possible standing in front of a shelf, not by rebuilding. Settings gets a selector:
    a supermarket reading comes out of the phone or out of the board's speaker.
    The part that is not obvious is the ordering. Sending the reading to the board used
    to be `void` after the announcement — a best-effort copy for hardware nobody had. It
    can now be the only output, so it has to finish INSIDE the audio session the reading
    holds open: with the screen locked, iOS only lets the app run while the keep-alive is
    playing, and a send left outside that wi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
2026-09-11 fix(audio): español, volumen y el «null» — los tres defectos de la primera prueba real (#84)
    * fix(audio): the board read in English and too quietly, both heard on first use
    Two defects that only a working speaker could reveal, found the first time a reading
    actually came out of the board.
    **English.** The cloud TTS request carried model, voice, input and response_format and
    no indication of language at all. `alloy` starts from English, and a product name with
    brands in it is not enough for the model to switch on its own. The phone never had the
    problem because `expo-speech` is handed `es-UY` explicitly, so this had been wrong
    since synthesis.ts existed and could not surface until som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
    [__main__.py, audio.py]
2026-09-14 fix: el doble click, la reconexión y el enlace — verificado en la placa (#85)
    * fix(device): a 50 ms debounce is an upper bound on how short a click may be
    The first double click of every session landed on bus mode. It was not the mode
    machine, which was right and tested: it was `bounce_time`.
    gpiozero does not read it as "ignore bounce after a press". It ignores every edge
    inside that window of the previous accepted edge, the release included — so the
    debounce is an upper bound on how short a click may be. A click shorter than it
    loses its release, the following press then looks like no state change at all, and
    the double click collapses into ONE click. The 50 ms had been chosen as "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
    [__main__.py, ap.py, button.py, http_server.py, link.py]
2026-09-14 fix(app): less screen — one theme, one status line, the mode on its own (#86)
    * fix(app): Home shows only the mode; the device status leaves for the Device tab
    The section title, the device status line and the "Modo actual" caption are
    gone from Home. The Device tab already answers whether the device is usable,
    and saying it twice with two vocabularies made Home a dashboard inside an app
    for people who do not see it. The mode keeps a screen-reader caption because
    "Esperando" alone does not say what is waiting. The read button's hint now
    points at the Device tab instead of "above".
    Also "Qué reconoce" drops "almacén": it says supermarket food and products.
    The model prompt is untouched;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
2026-09-16 docs(omnibus): el camino de ómnibus, del repo de Magalí a la placa (IMX500, PaddleOCR vía ONNX, modo vigilancia) (#87)
    * docs(omnibus): el camino de ómnibus, del repo de Magalí a la placa
    Consolida en una rama al día con staging lo que el PR #63 traía 22 commits
    atrás, más la sesión del 2026-09-14:
    - SESSION-LOG: 2026-09-07 (el repo de Magalí anda; IMX500 en vez de Coral; el
    detector del banner se fine-tunea), 2026-09-13 (repo en inglés, detección
    partida en bus/sign) y 2026-09-14 (el modo ómnibus corre en la placa: el
    COCO del sensor detecta y la placa dice "se acerca un ómnibus"; el OCR lee
    115 / LUIS BRAILLE; el OCR de 10 s bloqueaba la cámara y pasa a un hilo;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
2026-09-16 feat(device): bus mode runs on the board, from the button, in 1.27 s (#88)
    * feat(bus): bus mode runs inside the daemon, with the detector in the sensor
    Until now the bus path only ran by hand over SSH. This wires it into the daemon
    so the physical button starts it and it survives a reboot (ADR 0006, amended
    2026-09-07: the detector lives in the IMX500, the Pi crops, reads and speaks).
    - camera.py loads the `.rpk` into the sensor at startup, not when the button is
    pressed: the first firmware upload after a boot takes about a minute. One
    preview configuration serves both uses, so `/photos/latest` still answers with
    the same 1024x766 JPEG (checked on the board).
    - bus.py owns bus mode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
    [__main__.py, audio.py, bus.py, camera.py, core.py]
2026-09-16 fix(app): the bus reading is heard where the user chose, not always on the board (#89)
    Reported on 2026-09-15: with the setting on "phone", a bus reading still came out of the board.
    The setting had no effect because neither half of it existed. The device cannot know what Settings
    says, so it used its own default (itself) and spoke over the choice; and the app never listened to a
    bus reading, so simply silencing the device would have produced silence instead. Both halves are
    here:
    - The app writes {"cmd":"audio","target":...} to the control characteristic on every connection and
    on every change of the setting. Both, because the device forgets on reboot and the user can change
    their min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
2026-09-16 fix(app): every sound follows the output setting, not just the two readings (#90)
    Reported with the glasses on: the supermarket and bus readings could be sent to
    the board or the phone, but "connected", "network ready" and the mode change only
    ever came out of the phone.
    The setting was never a rule. It was two call sites that remembered to ask
    (`decideDelivery`); everything else called `announce()` straight, which is
    `expo-speech` and therefore always the phone. With the output on the board the
    user heard the product from the glasses and every other sound from their pocket,
    which reads as the app being broken rather than as a smaller feature.
    A **system notice** is now a first-class thing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
    [__main__.py, core.py, gatt.py, notices.py]
2026-09-17 fix(app): a board complaint must not be delivered by the board (#91)
    Found on the first real use, within the hour of shipping.
    `deviceWarning` had a clip, so with the output on the board the notice "el
    dispositivo avisa: …" was sent TO the board. The board was still running the old
    daemon, which does not know `say`, so it answered `{"t":"error","msg":"unknown
    command: say"}`. The app turns every board error into that notice, which went back
    to the board as another `say`, which was unknown again — an unbounded exchange of
    BLE writes in which nothing is ever spoken. From the outside it is
    indistinguishable from the feature simply not working, which is how it was
    reported.
    The rule that r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
    [__main__.py, core.py, notices.py]
2026-09-17 feat(device): the system notices, verified on the board, and the boot scripts into git (#93)
    The app half shipped yesterday; this closes the other half and proves it on
    hardware rather than on the Mac.
    The cause was neither of the two we assumed. `SIN-AP` did not exist on the card —
    only `._SIN-AP`, the resource file macOS leaves beside anything copied to a FAT
    volume. The real file had been deleted and its companion survived, which in a
    listing looks exactly like the file being there. So the board was booting into
    product mode, raising its AP and leaving every other network: no SSH, invisible on
    the WiFi. The phone still saw it because BLE works the same in both modes, so
    nothing pointed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
2026-09-17 fix(app): the link is the phone's to announce, and GATT operations queue (#94)
    With the output set to the device the app could no longer join the board's WiFi.
    With the output on the phone the very same build worked — the A/B that named the
    cause.
    "Dispositivo conectado" is announced the instant the link comes up, and when the
    announcement goes to the board that is a GATT write on `control`, fired without
    `await` one line before the app READS the `wifi` characteristic to learn the AP's
    credentials. Two characteristic operations in flight on a peripheral that had just
    connected. The read came back empty, `readWifi()` answers null for every failure,
    and with no credentials there is nothing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
    [notices.py]
2026-09-17 docs(tesis): the formal body of the thesis, written from what the repo had already measured (#92)
    * docs(tesis): the formal body of the thesis, written from what the repo had already measured
    Adds docs/tesis/: one file per chapter of the final report, built from the ADRs, the three
    measurement campaigns, the session log and the bus pipeline repository.
    - 03: the four state-of-the-art sections that were empty (bus-sign OCR, shelf products,
    real-time detection on the edge, communication protocols).
    - 04: new theory blocks (IoU/mAP, one-stage detection and YOLO, two-stage OCR, edge AI and
    quantization, BLE/GATT and WiFi, speech synthesis and audio session, WCAG).
    - 05 to 08: methodology,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
2026-09-18 docs(qa): cómo probar los avisos de sistema de punta a punta (#95)
    * docs(qa): cómo probar los avisos de sistema de punta a punta
    Escrito después de dos días en que este camino falló tres veces seguidas y las tres
    en silencio: la app entregada sin la placa, un lazo de realimentación que no decía
    nada, y una escritura BLE que impedía unirse al WiFi y se reportaba como «no se pudo
    conectar a la red».
    De ahí la forma: cada bloque dice qué prueba y a dónde mirar si falla, porque el
    síntoma de este subsistema casi nunca está donde está la causa. El bloque 0 —alinear
    la app y la placa— va primero porque esa fue la causa raíz de los tres fallos, y
    TestFlight publica sólo la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
2026-09-18 docs: dos formas de romper la placa sin que nada lo diga (#96)
    Alinear la placa con el catálogo de 6 avisos sacó dos trampas de despliegue, y las
    dos fallan en silencio.
    El tar de macOS deja los .py en 0 bytes al extraerlos con GNU tar en la Pi: nombres
    y fechas correctos, contenido vacío. El daemon arranca, importa módulos vacíos, sale
    con código 0 y systemd lo reinicia en bucle; en el journal no hay una sola excepción.
    Lo que lo delató fue `python -m virovision --help` contestando nada con exit 0. Se
    copia con scp de los .py sueltos, y se verifica que los BYTES coincidan de los dos
    lados, no que los archivos existan.
    Y la tarjeta le gana a la placa en cada arranque: modo-red.sh r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
2026-09-19 fix(audio): one voice at a time, whichever output it comes from (#97)
    Found using the board. With the output on the device, "Probar audio" starts playing
    on the speaker; switching the setting to the phone mid-sentence and pressing the
    button again, the phone starts the same sentence **without cutting the board off**,
    and the two talk over each other.
    Each output knew how to interrupt itself and neither knew how to interrupt the
    other. The phone calls `Speech.stop()` before speaking; the board kills the previous
    `aplay` before playing. Both rules are right and together they are not enough.
    This is not cosmetic. It has been written in `audio.py` since the first day — "two
    voices at once is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
    [__main__.py, core.py, gatt.py]
2026-09-20 docs: la placa volvió a ser la Zero 2 W, y con ella se fue el cable (#99)
    * docs: la placa volvió a ser la Zero 2 W, y con ella se fue el cable
    La Pi 3 B+ prestada cubrió diez días (2026-09-09 -> 2026-09-18) mientras la Zero tenía el CSI roto.
    La unidad que está en uso desde hoy es otra Zero 2 W, con la cámara respondiendo, y trae de vuelta la
    restricción que la placa prestada había tapado: no tiene puerto Ethernet.
    El acceso por cable directo Mac <-> Pi era lo primero que recomendaba placa-acceso.md y ahora no
    existe. El orden pasa a ser tools/ap.py por BLE (5 s, no persiste), SIN-AP en la microSD (persistente)
    o entrar al AP desde una máquina con dos interfaces. La sección del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
2026-09-21 fix(device): connect fast and stop asking to join the board's WiFi (#100)
    * fix(hardware): advertise every 100-152.5 ms, not every 1.28 s
    Read off the board on 2026-09-20: adv_min_interval = adv_max_interval = 2048, the kernel's
    default 1.28 s. The unit pinned the connection interval through debugfs and never the advertising
    one. A phone only finds the board - and only completes a direct connect to a remembered
    identifier - when it catches an advertisement, so that interval was a floor under every
    connection, not just the ones that scan.
    Measured from the Mac with the AP up (as it is used): at 1.28 s, two of six searches did not see
    the board within 20 s; at 100-152.5 ms, zero of twelve. 1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
2026-09-22 fix(bus): ver por qué el modo ómnibus no leía, y que la cámara no se trabe (#101)
    * feat(bus): a timeline in the journal, so a slow detector and a slow reader stop looking alike
    Field runs left three kinds of line - there is a bus, read in N ms, the line - and nothing that
    said where the seconds went between the bus entering the frame and the line being spoken. The
    report of 2026-09-21 has three symptoms (sometimes it takes long to even notice the bus, sometimes
    only half the sign is read, sometimes the line comes out at once) that live in different stages,
    and the journal could not tell them apart.
    Every track now gets a birth line with the bus and sign heights, a status line per seco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
    [bus.py, camera.py]
2026-09-22 chore(bus): open every run's journal with the pipeline checkout it reads with (#102)
    The pipeline package is installed as a wheel built from a branch of another repo, whose PRs are
    merged by someone else: a branch is the one under test for days, and every build of it calls itself
    0.2.0. Knowing which code a field run used meant grepping the installed sources for a symbol
    (2026-09-22). That repo's deploy now leaves branch, commit and time in models/bus-banner-version, and
    the daemon prints it next to "bus mode ready". A board deployed by hand says so instead of failing.
    [bus.py]
2026-09-22 feat(bus): que la placa avise que se está preparando, en vez de quedarse muda (#103)
    * feat(bus): say that bus mode is warming up instead of going silent
    Reported by the user on 2026-09-22: the OCR takes tens of seconds to load after power-on, and the
    button was answering that window with nothing. For someone who cannot see the screen, a device that
    says nothing is indistinguishable from a device that died - and it is the first thing that happens
    after switching it on, so it is the first impression the product gives.
    The board now says «Modo ómnibus. Preparando la lectura, esperá unos segundos» the moment it is asked
    to watch before it can, and BEFORE it starts building, or the notice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
2026-09-22 fix(bus): decir el destino, y que el teléfono pueda escuchar que se acerca un ómnibus (#104)
    * fix(bus): say the destination, and let the phone hear that a bus is coming
    Two things a real run found, both on the way from the board to the phone, both invisible in the
    journal because the board did its half correctly.
    **The destination was read and then dropped.** The board decided «Bus 115, LUIS BRAILLE» and put
    `detail` on the wire, as it has since the event was designed; the app's `Detection` had no such
    field and its formatter said `Línea ${label}`, so a user listening on the phone heard "Línea 115"
    and nothing about where that bus was going - which is the half that tells two buses o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
    [bus.py]
2026-10-05 fix(hardware): lift the rfkill block on Bluetooth before every daemon start (#106)
    systemd-rfkill restores a saved soft block on every boot, which left the board
    with PowerState off-blocked and the daemon crash-looping on set_powered: it
    never advertised and no phone could find it. setup.sh's rfkill unblock never
    ran because the binary is not installed; both now write to sysfs.
    [__main__.py]
2026-10-05 fix(device): recover from a jammed camera, keep the journal, and fix the bus phrase without a number (#105)
    * fix(camera): never hold the capture lock behind a sensor that will not close
    * fix(hardware): keep the journal across reboots
    * fix(bus): say the destination alone when the line number was not read
    * docs: log the camera hang, the volatile journal and the dead telemetry URL
    [camera.py]
2026-10-06 perf(device): advertise before the camera and the AP, and stop waiting blind between reconnects (#107)
    * perf(device): advertise before the camera and the AP, and stop waiting blind between reconnects
    The board started the camera (about a minute to load the IMX500 detector after
    a boot) and brought the AP up (with retries up to 65 s) before advertising, so
    it was invisible to every phone for that whole time, and any hang there left it
    invisible for good. It now advertises first and starts the camera in the
    background: a photo meanwhile answers 503, a bus-mode press hears the warm-up
    notice and the mode begins once the camera is ready. status is pushed as soon
    as the AP or the camera comes u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
2026-10-06 perf(wifi): offer the DHCP lease without dnsmasq's 3 s ping, and probe the join every second (#108)
    * perf(wifi): cap each probe at 1 s while waiting for the join
    A probe sent before the phone has its DHCP lease only ends when it times out,
    so the cap is how late the first probe that can succeed starts. Measured on
    2026-10-06: the lease arrived and the next /health landed 2.5 s later with
    the old 3 s cap.
    * perf(hardware): stop dnsmasq from pinging an address before offering it
    dnsmasq waits up to 3 s for an answer to a ping before each DHCP offer. On the
    board's AP that was a third of the time between accepting the join prompt and
    the network being ready; with no-ping the offer leaves in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
2026-10-06 fix(hardware): keep the daemon answering BLE while bus mode loads (#109)
    * wip(hardware): keep the OCR build from freezing the daemon right after it advertises
    Not final: the OCR is pre-built in a low-priority subprocess first, which
    moves the freeze past the first connection on a cold boot, but building it in
    this process still holds the GIL for 10-20 s.
    * fix(hardware): keep the daemon answering BLE while bus mode loads
    On a cold boot the daemon stopped answering BlueZ for 13-17 s right after it
    started advertising, so a phone that connected then got no reply to its first
    GATT read and iOS dropped the link after 30 s. Two causes, measured on the
    board: Debian's python3-opencv links 380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
    [__main__.py, bus.py, core.py, ocr_worker.py]
2026-10-06 perf(hardware): start the daemon as soon as Bluetooth is up (#111)
    The daemon waited for cloud-init, NetworkManager and network-online, none of
    which it needs since it advertises first. It now depends on bluetooth.target
    only, cloud-init is disabled once the board is installed, modo-red.sh only
    reloads units or NetworkManager when something changed, and the AP polls for
    NetworkManager instead of failing once and retrying after a fixed 5 s.
    Measured on the board: advertising at 16.2 s from the kernel instead of 27.0 s.
    [__main__.py, ap.py]
2026-10-06 feat(hardware): report the battery level from the UPS HAT's INA219 (#110)
    Read the cell voltage over I2C (0x43) and map it to a percentage through a
    LiPo discharge curve, smoothed across status heartbeats. Enable I2C in
    setup.sh, since Raspberry Pi OS Lite ships it commented out.
2026-10-07 chore: codebase review, and errors go only to telemetry (ADR 0011) (#112)
    * fix(app): keep error text off the screen and out of the voice
    Every error's own text (the board's notices, the system's WiFi join error,
    the device's IP, an HTTP body from the cloud) now goes only to the
    telemetry table. The user hears a fixed, plain-language sentence that says
    what to do, never what broke.
    - notify() loses its detail parameter; deviceWarning and modeWriteFailed
    notices are gone, recorded only.
    - The Device tab drops the error panel (wifiDetail / lastNotice).
    - A shared errorDetail()/errorType() caps what reaches telemetry.
    * feat(telemetry): capture every error and log silently
    - console.* (ap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
    [__main__.py, audio.py, bus.py, camera.py, core.py, gatt.py, http_server.py, link.py]
2026-10-13 feat(evidence): keep bus mode's frames and OCR crops, linked to their telemetry row (#114)
    Development only; removed before the final version (docs/ROADMAP.md).
2026-10-13 docs: log the release (#115) and the board deploy (#116)
2026-10-13 docs: the board now reads with bus-banner's single branch (#117)
2026-10-15 feat(hardware): VIA Clara v0.9 case — snap-fit halves on the real board stack (#120)
    * feat(hardware): VIA Clara v0.9 case — snap-fit halves, integrated camera chamber, no screws
    Builds on the v0.8 OpenSCAD model (kept alongside as reference) and applies the
    final case spec: six snap tabs + alignment lip + rear pins instead of screws, the
    AI Camera captured by edge ribs inside both halves with a single lens opening,
    heat-staked pads for the existing standoffs, UPS switch and charging windows,
    two button drawers, and a 14 mm bone transducer pocket. export.sh regenerates
    the STLs and images and runs six interference checks.
    * feat(hardware): case v0.9 on the real stack — one mode butto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
2026-10-22 feat(hardware): zoom the ISP on the bus sign, and read the YOLO box as is (#121)
    * feat(hardware): zoom the ISP on the bus sign so the OCR gets real pixels
    Field test of 2026-10-19: the bus was detected from far away, but its sign
    only became readable with the bus almost in front of the user. The crop came
    from a 1024 px stream over a 4056 px sensor, and upscaling it only enlarged
    the blur.
    Bus mode now steers the ISP's ScalerCrop towards the widest sign the sensor
    reports. The IMX500's inference region is a separate control, so the
    detector keeps the whole field of view: the tracker keeps working in
    full-view coordinates and only the crop handed to the OCR is translated
    into the zoomed fr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
2026-10-22 fix(hardware): give the bus sign room again, the most on the left (#122)
    Reading the detector's box as is kept losing the first digit of the line
    in the field. The margins come back to the values measured on the 117
    evaluation images (18 % left, 6 % right and vertical), passed explicitly.
    With the zoom on, a read is skipped when the zoomed frame cuts the margin,
    not only the sign: the pipeline would clip it at the edge silently.
2026-10-23 docs: bring the three pillars' documentation up to date with the code (#123)
    * docs: bring the three pillars' documentation up to date with the code
    App, ML, hardware and the VIA Clara case: drop the Coral TPU, Camera Module 3 and
    DAC I2S leftovers; document the catalog rules, evidence, ISP zoom, sign margins
    (and why the "1" was lost), the V100 retrain, battery, boot timing and case
    v0.9 to v0.12. Thesis chapters 3 to 8 and the annex updated; new zoom campaign;
    dated update notes on ADRs 0001-0004, 0006 and 0007; skill rewritten in Spanish.
    * docs: fix the first review round's findings
    Unsourced "in the street" claims about the lost "1" become the team's tests; the
    zoom picks the largest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
2026-10-31 feat(hardware): case v0.20, printed and assembled, with every version's STLs (#124)
    * feat(hardware): case v0.10 from the first print — stack staked on the Pi side, slimmer walls, camera turned 90 degrees
    The v0.9 print fitted almost everything. What it showed: the hex standoffs stand
    above the Pi and only Phillips heads sit under the HAT, so the stack is now staked
    to the right half; the microSD needed the rear end cut away, so the rear leaves
    the card real room; the walls go from 2.2 to 1.6 on the sides and 2.7 to 2.4 top
    and bottom (28.7 x 36.6 instead of 31.4 x 37.6); the camera turns 90 degrees in
    its plane so the image matches the wearer's view, with its connector toward the
    Pi and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
2026-11-02 feat(app): product mode hides the photos, result fields and model selector (#125)
    * feat(app): product mode hides the photos, result fields and model selector
    Settings gets an app-mode choice: product (default, the clean app) or
    development (photos, result rows, bus shots, notices and the model
    selector). Only the screen changes; telemetry and evidence upload do not
    read it.
    * feat(app): product mode keeps the spoken phrase and drops the device status line
    Review fixes: the failed capture is a typed failure instead of a match on
    the Spanish text, and goes without the result caption; a choice made
    before the stored mode loads is no longer overwritten; with no cloud
    model the notice moves t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
2026-11-03 fix: full-codebase review (app, hardware, supabase, ci) (#126)
    * fix(app): honour the device timeout, sync the board's mode on connect, keep telemetry offline
    - ReaderBridge passes the AbortSignal to sendAudio, so the 8 s delivery limit reaches the POST.
    - The bus reading is copied to the board only with output=device and the board reachable: before,
    output=phone heard it twice and an unreachable board paid a cloud synthesis for nobody.
    - connect() reads the mode characteristic once (the board does not notify it on subscribe) and a
    lost link forgets deviceMode: a restarted daemon came back idle while the app stayed in bus mode.
    - Telemetry: a network failure no longer counts toward the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
2026-11-07 feat(app): app mode is a dropdown in Settings, like the model (#128)
    * feat(app): app mode is a dropdown in Settings, like the model
    The two inline options took the room of two buttons for a switch only the team uses. Both
    selectors now share DropdownSelect, extracted from ModelSelector, so they sound the same to
    a screen reader.
    * fix(app): review fixes for the settings dropdown
    The app-mode phrase waits for the menu to close so it does not talk over the screen reader,
    re-picking the current model still persists it, and the app-mode card drops its duplicate
    header. Session log entry for the new board and this change.
    * test(raspi): wait for the missing-notice error itself, not the play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
2026-11-07 docs: fixed AP key as an accepted risk (ADR 0003) (#127)
    * docs: record the fixed AP key and unauthenticated HTTP as an accepted risk
    The full-codebase review flagged that the AP password is public in the repo and the board's HTTP
    server does not authenticate, so anyone nearby could fetch the latest photo or play audio. With a
    single unit and no plausible adversary in the thesis's scope, the team accepts it for the prototype
    (ADR 0003 update, thesis risk table) and leaves a per-unit key plus a per-session token as future
    work.
    * docs: note the redeploy of the vision and evidence functions
2026-11-10 feat(hardware): case v0.26, the camera turned so the picture is upright (#129)
    The v0.20 gave a picture turned 90 degrees when worn, and the bus detector runs
    inside the sensor. The v0.22 turns only the camera (connector down) and was chosen
    over the v0.21 (the whole case turned). On top of it, from the prints:
    - v0.23: camera 2 mm further from the boards (coiled flex); transducer cover
    1.5 mm taller
    - v0.24: microSD slot 1 mm toward the seam; front camera rib open along the
    whole bottom band
    - v0.25: button centred; cavity 1.2 mm taller each side for the Pi's ports
    (2 mm, not 0.8); hex sockets 2 mm deeper; wider snap hooks, 0.5 bump
    - v0.26: elastic bridges 5.5 up and arm socket 5.5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
2026-11-12 feat(hardware): case v0.29, the earpiece cup as its own part (final) (#131)
    v0.27 splits the transducer cup from the arm (plug/socket joint), widens the
    cable channel and replaces the 90-degree bend with a 3 mm radius curve.
    v0.28 shrank the cup plug by mistake; v0.29 sets it to 6.0 mm (0.15 mm
    clearance per side) with test plugs. v0.29 is printed and is the final case.
2026-11-12 docs: thesis revised after the team's review, and repo docs up to date (case v0.29) (#132)
    * docs(thesis): bring the team's edits from the Google Doc into the repo
    The team reviewed and rewrote parts of the thesis directly in the Doc since the last publication
    (chapters 3 and 4 swapped, the theoretical framework rewritten, bold lead-ins removed, citations
    added). The repo is the source of truth, so the Doc is imported first; sync_doc.py reports no
    differing section after the import.
    * docs(thesis): rewrite the development chapter and act on the team's review
    The team found the AI-written parts too bold and too punchy. Chapter 7 is rewritten in plain prose,
    with the problem, the alternativ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
2026-11-13 fix(raspi): PWM audio on GPIO 18 (pin 12), unamplified prototype (ADR 0012) (#130)
    * fix(raspi): move PWM audio to GPIO 18 (pin 12), next to the microSD
    * docs: the board's card already switched to pins 18/19
    * docs: prototype audio stays unamplified (ADR 0012), with power estimate and amplifier options
    * docs: the RC circuit test and the GPIO power ceiling that rules it out for street use
    * docs(thesis): errors are spoken by the phone; the I2S amplifier's wiring
    * docs: review fixes for the audio merge (cloud model stages, audio feedback scope, figures)
